ryood/TLF01/TLF01_Antilog/Antilog_NPNO/Analog_Discovery_2/IMG_20201010_154745.jpg

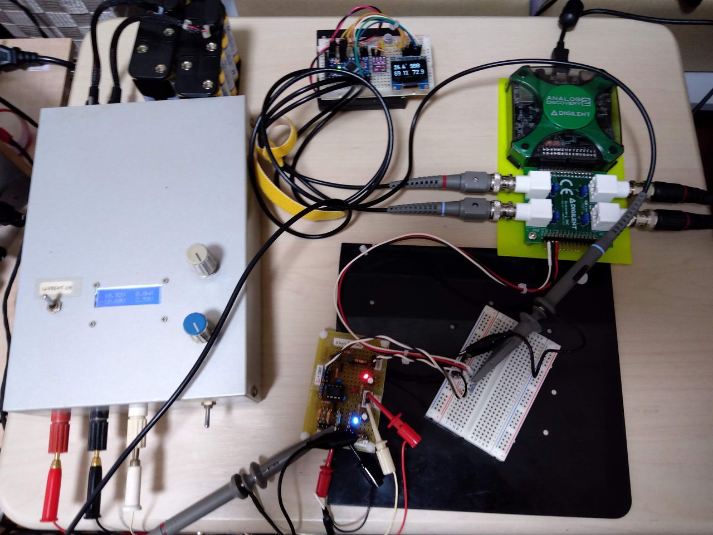
TLF01_Antilog/Antilog_NPNO/Analog_Discovery_2/IMG_20201010_154745.jpg
