ryood/TLF01/eagle/TLF01_brd.png

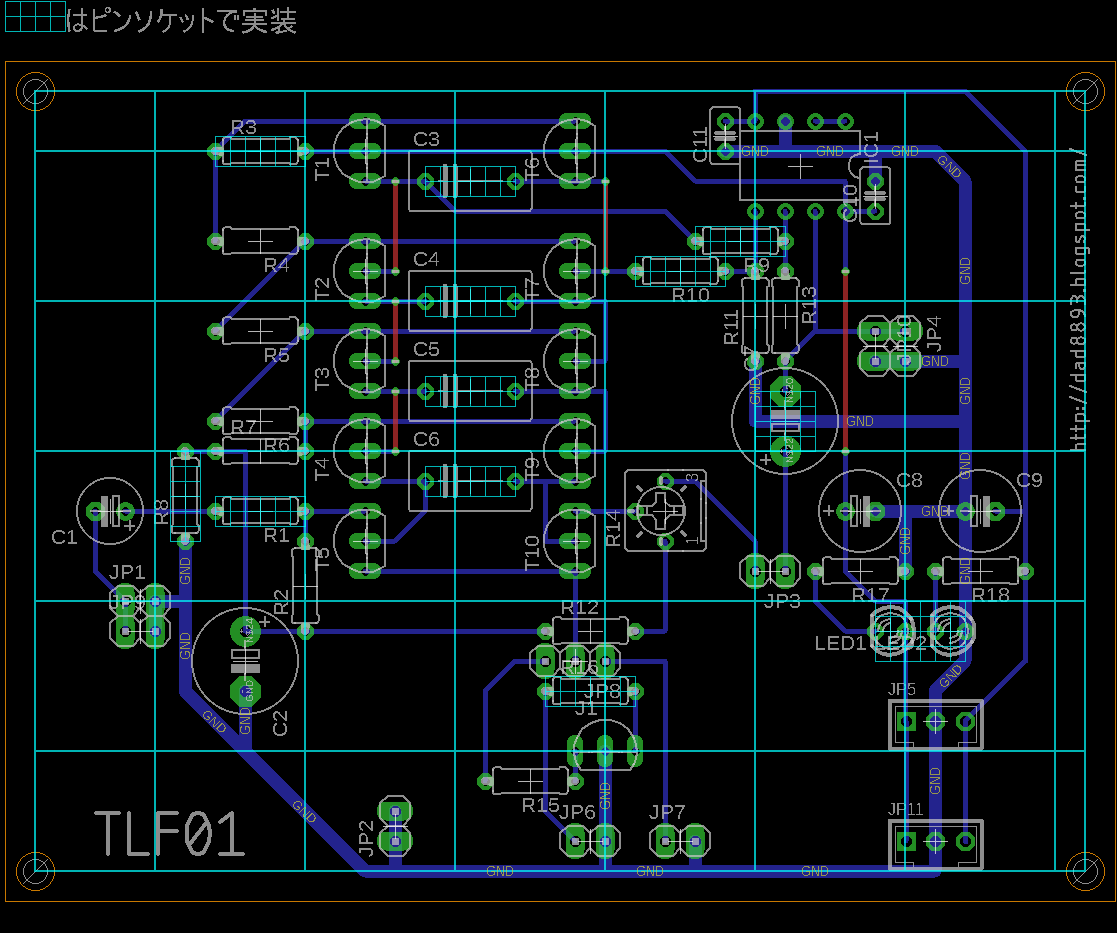
eagle/TLF01_brd.png
