ryood/TLF01/eagle/TLF01_sch.png

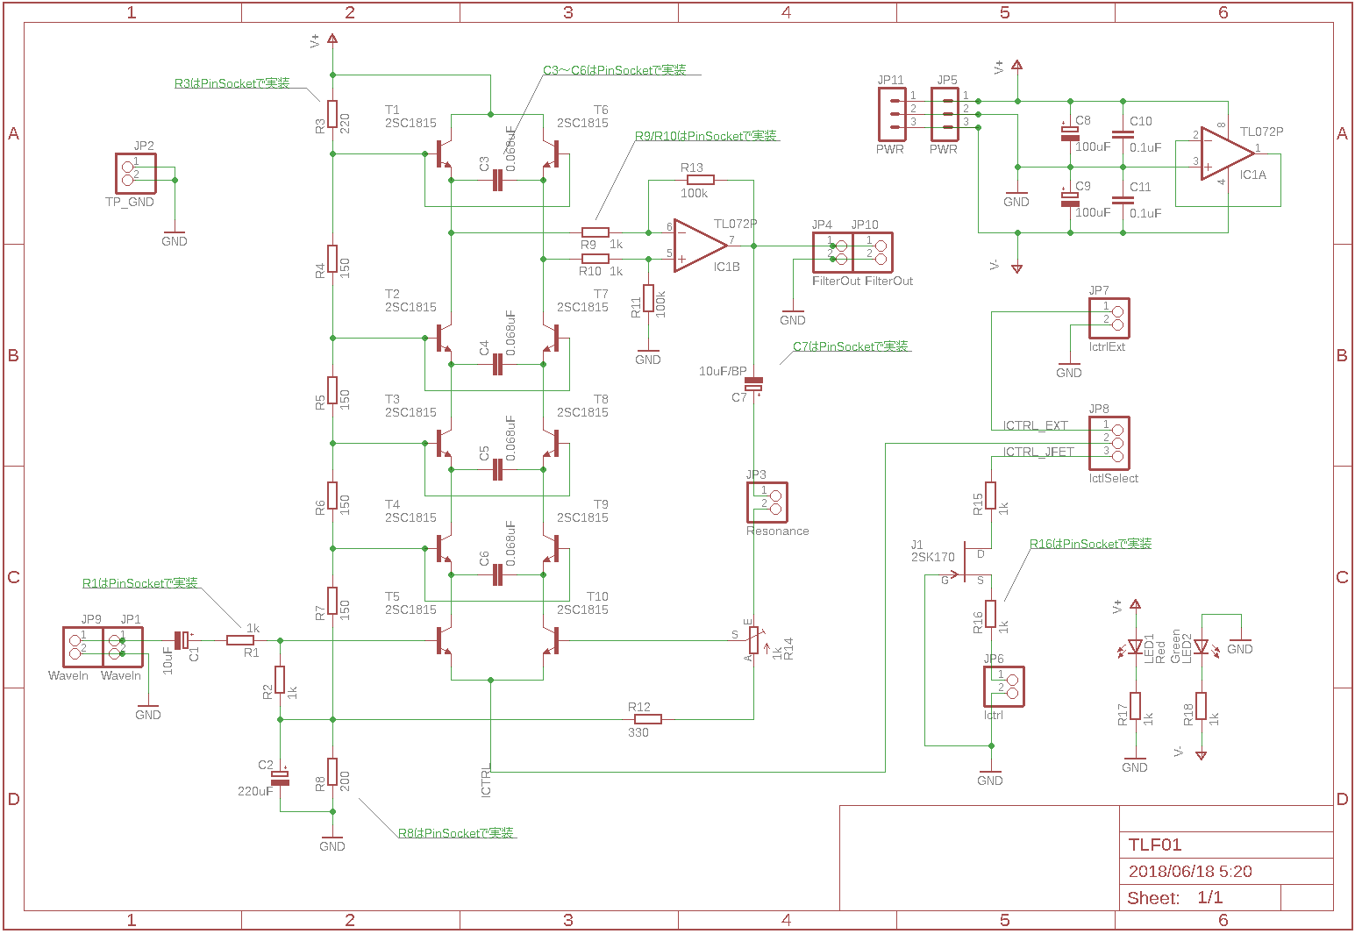
eagle/TLF01_sch.png
