ryood/TLF01/eagle/TLF01_toz_brd.png

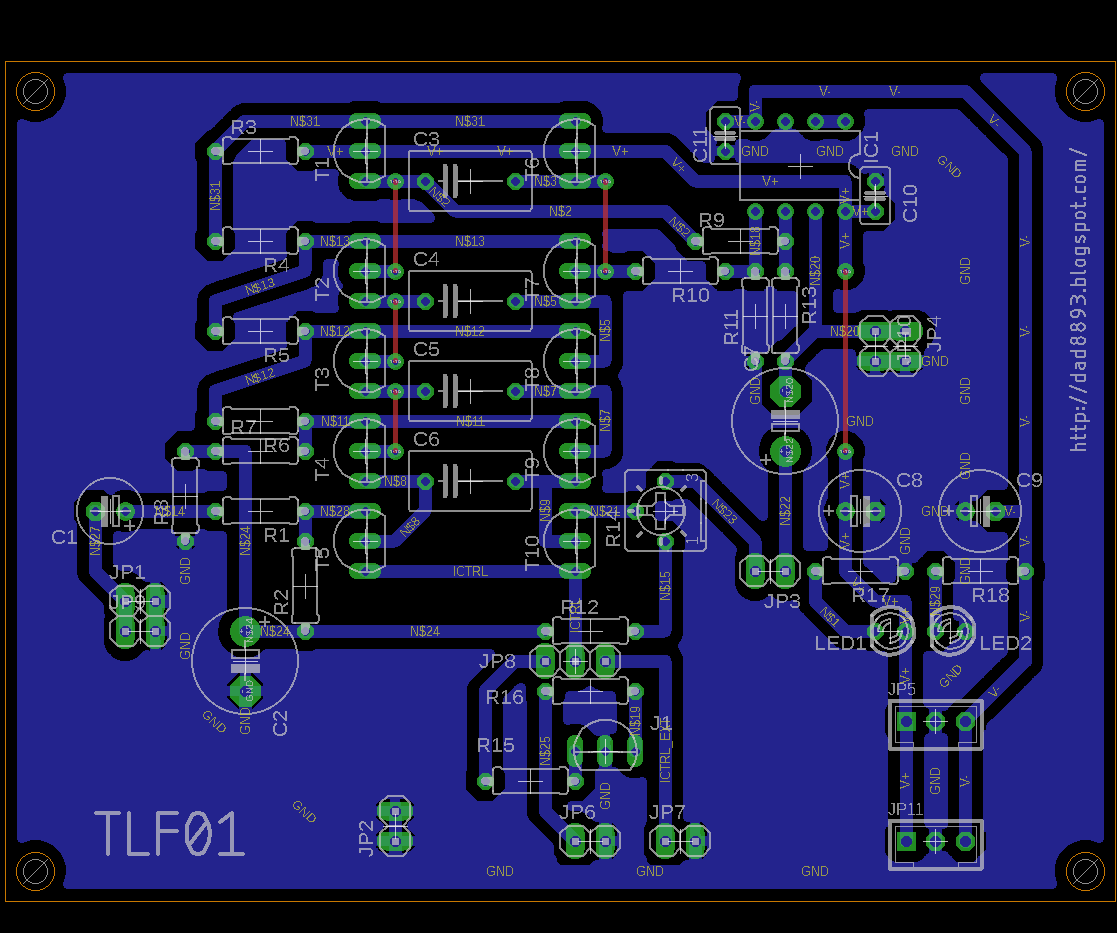
eagle/TLF01_toz_brd.png
