ryood/TLF01/fritzing/MoogLadder_CS_JFET_V2_ブレッドボード.png

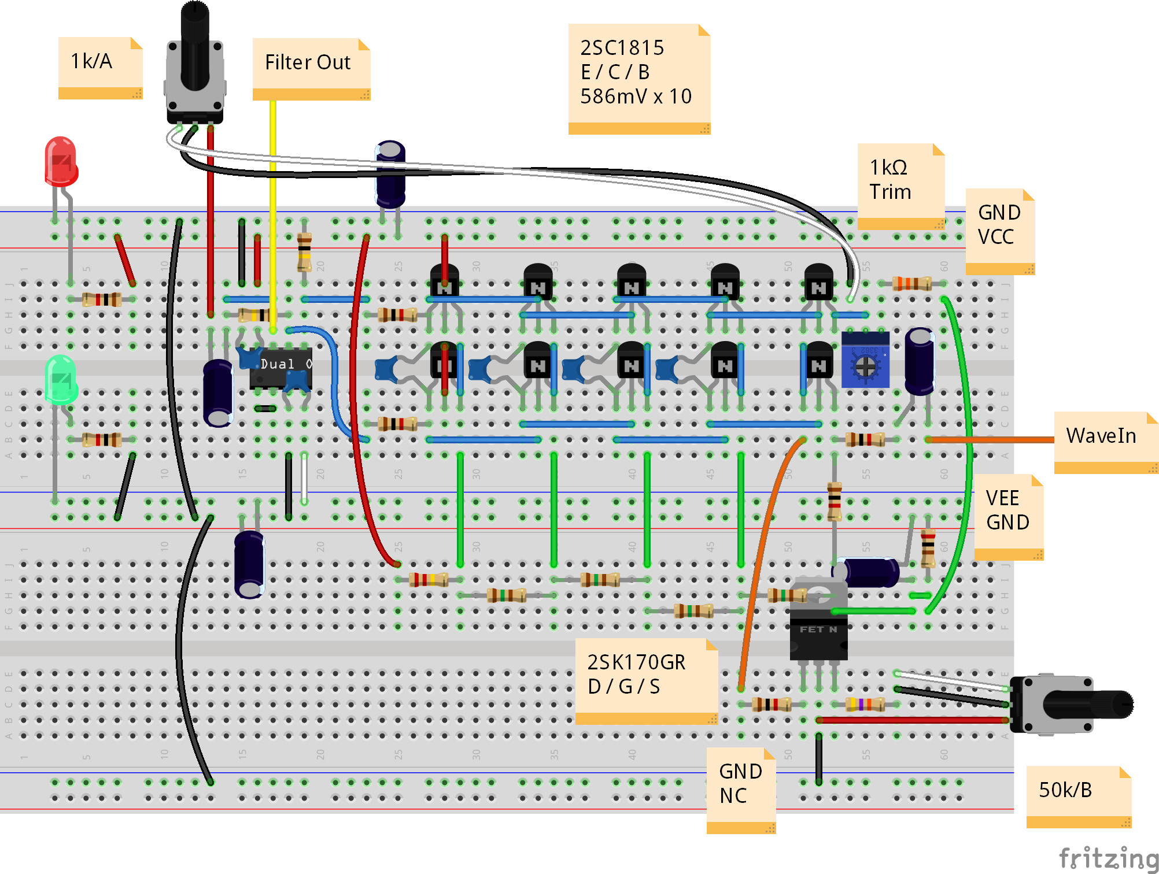
fritzing/MoogLadder_CS_JFET_V2_ブレッドボード.png
