ryood/TLF01/fritzing/TLF01結線図_ブレッドボード.png

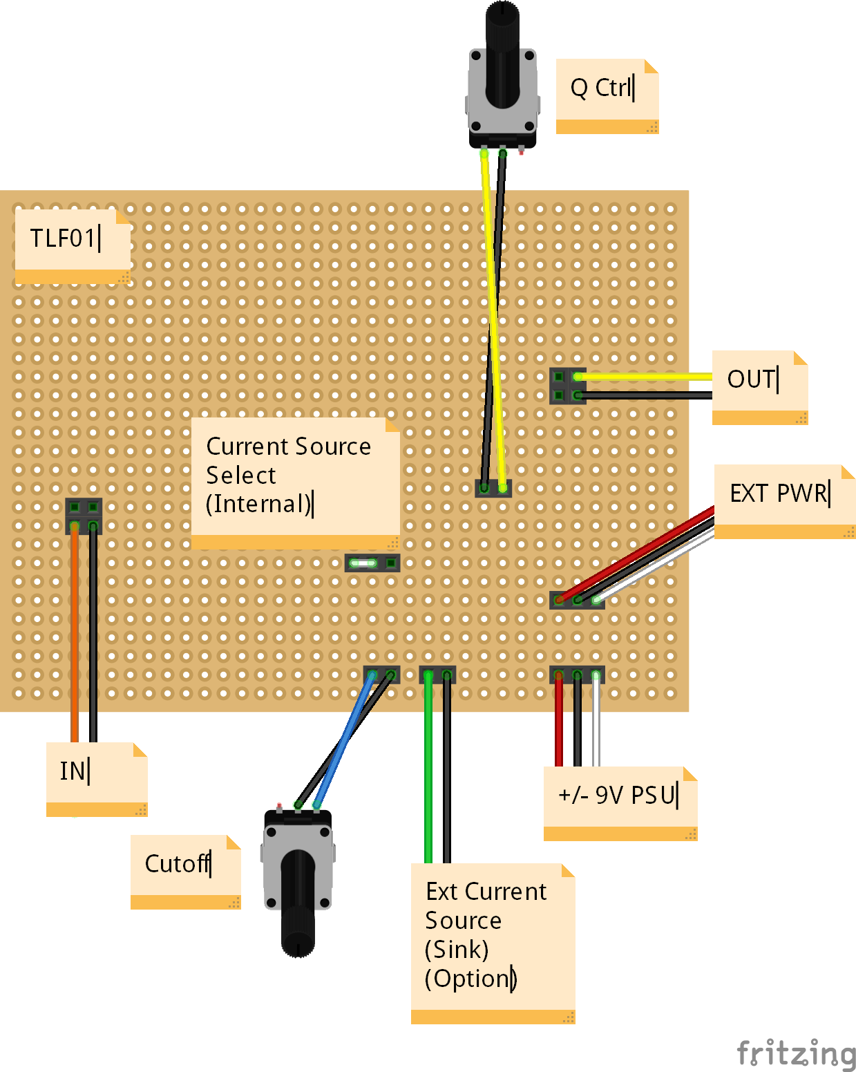
fritzing/TLF01結線図_ブレッドボード.png
