ryood/TLF01/spice/TLF01_sim.png

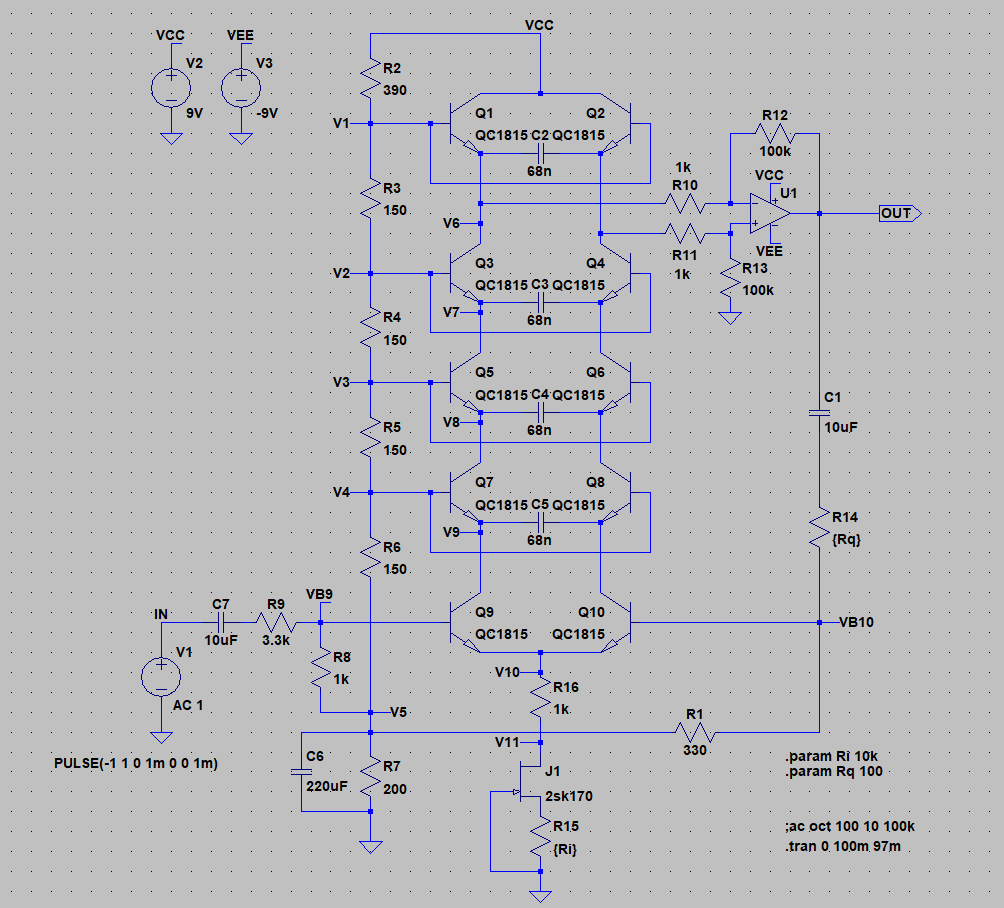
spice/TLF01_sim.png
