ryood/TLF01/spice/TLF01_V1-V5.png

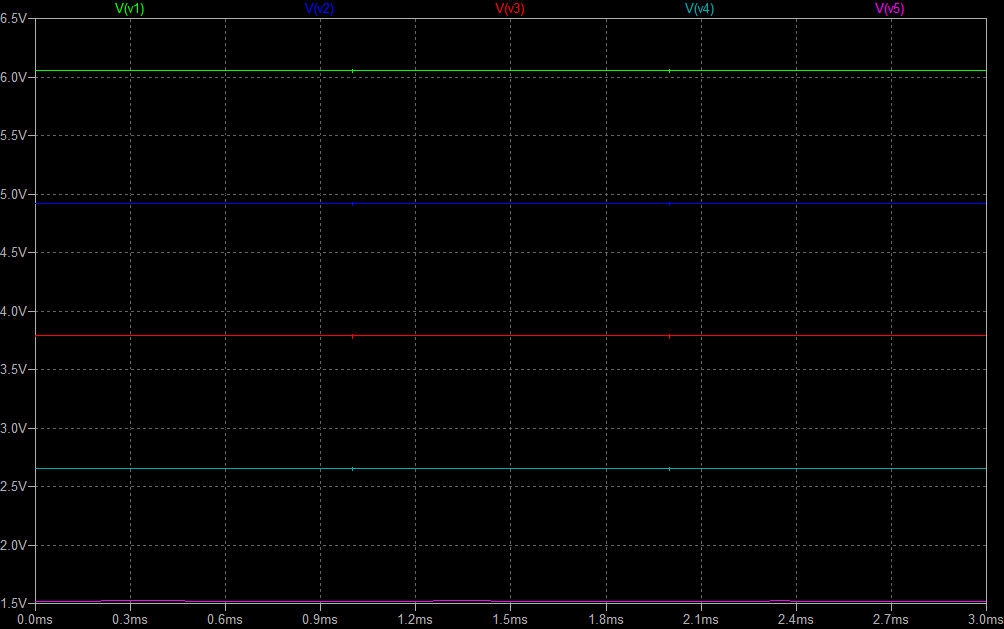
spice/TLF01_V1-V5.png
