ryood/TLF01/spice/TLF01_Vb9_Vb10.png

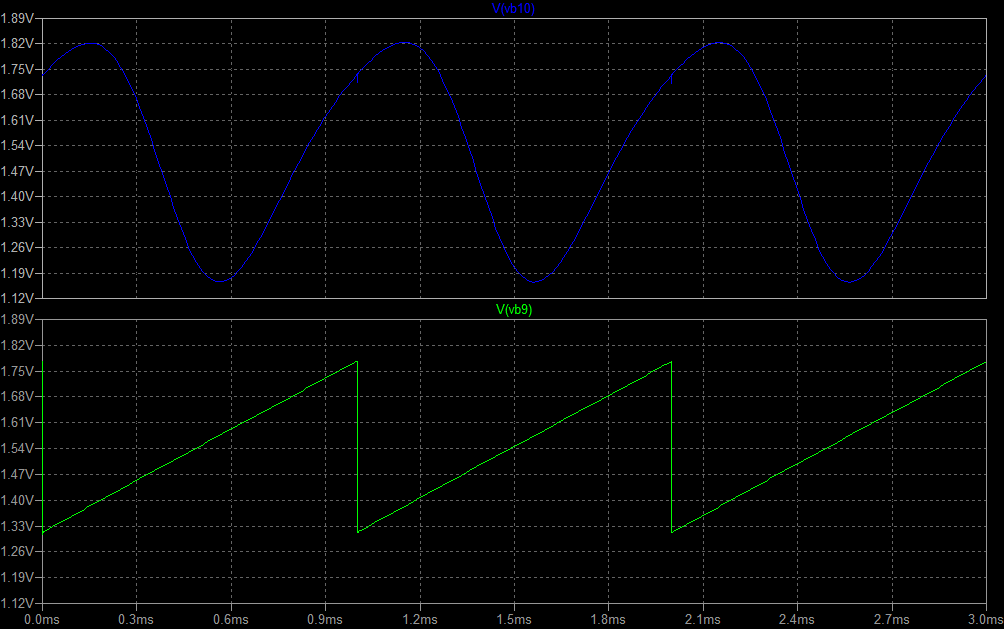
spice/TLF01_Vb9_Vb10.png
