ryood/TLF01/spice/TLF_Cfc_1u.png

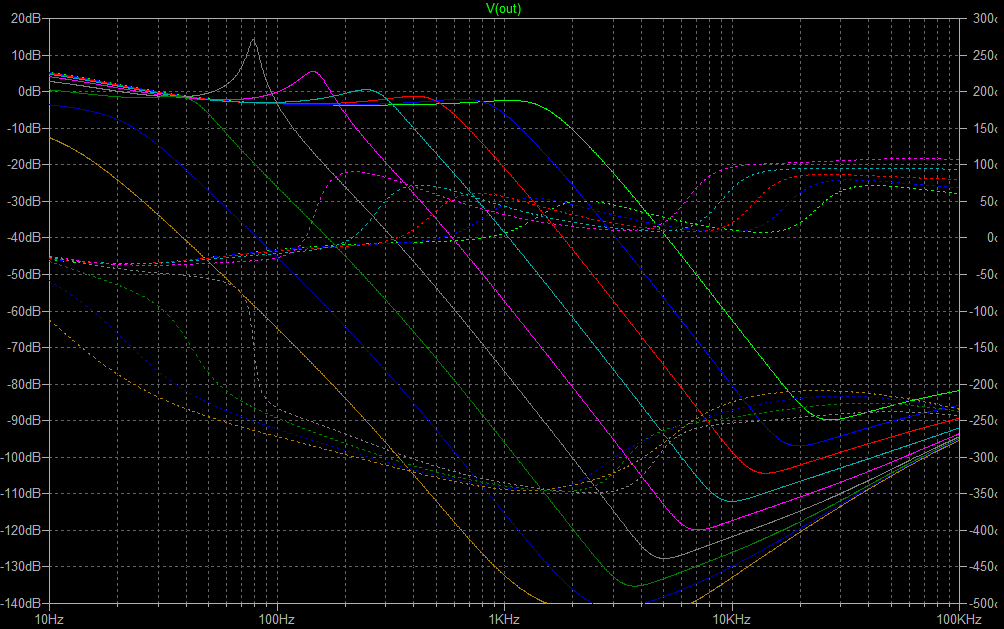
spice/TLF_Cfc_1u.png
