ryood/TLF01/spice/TLF_Cfc_68n.png

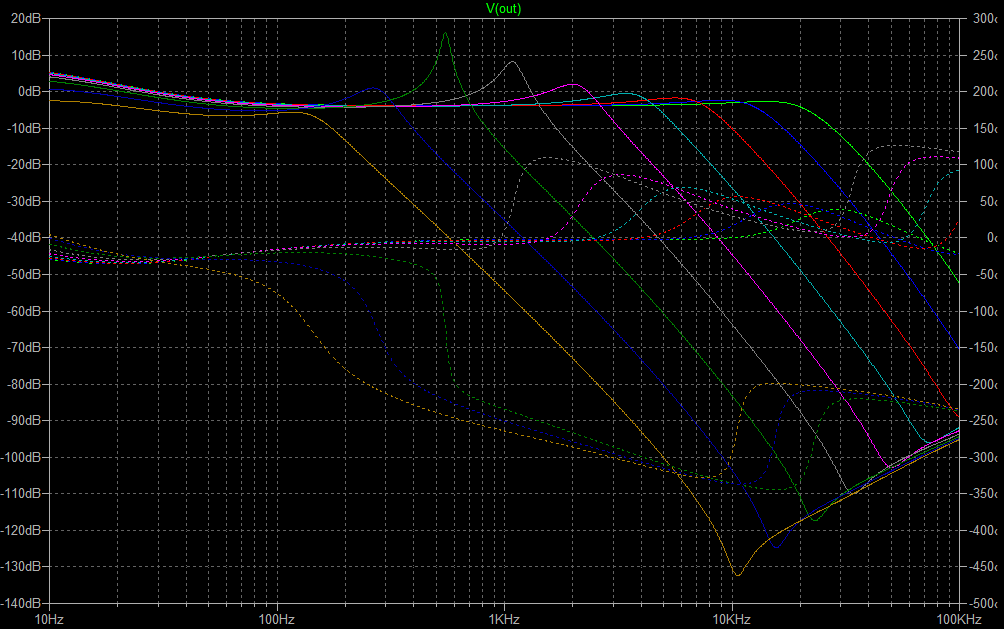
spice/TLF_Cfc_68n.png
