ryood/TLF01/spice/TLF_Cfc_100n.png

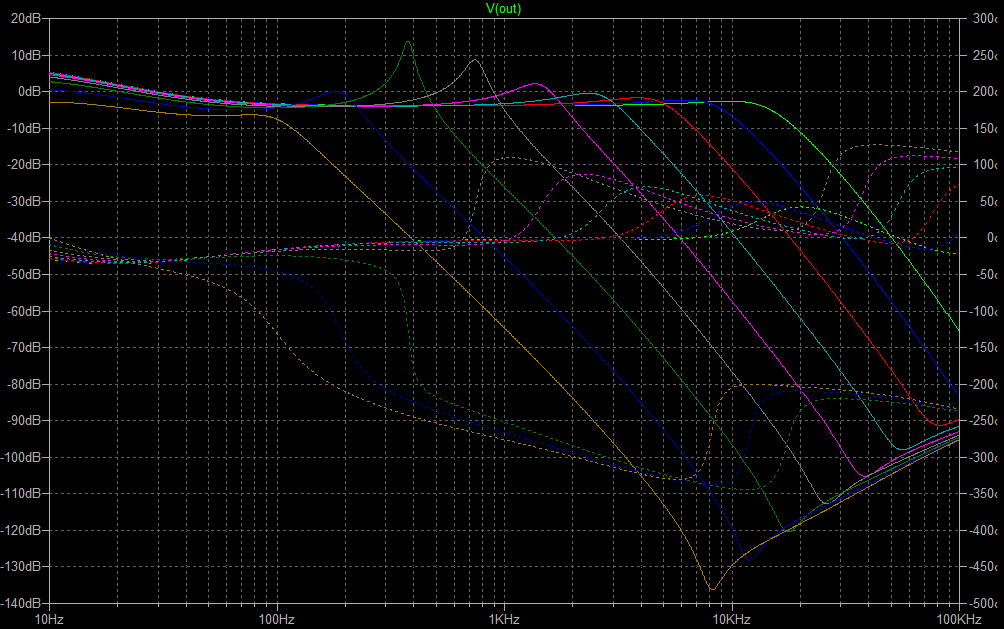
spice/TLF_Cfc_100n.png
