ryood/TLF01/spice/TLF_Cq_1uF.png

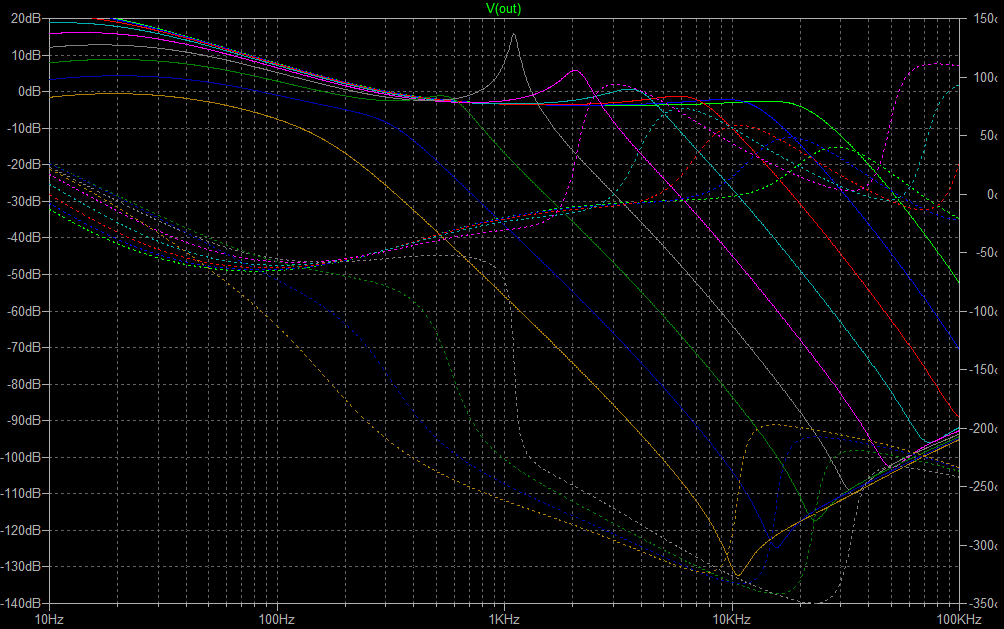
spice/TLF_Cq_1uF.png
