ryood/TLF01/spice/TLF_Ramp_1k.png

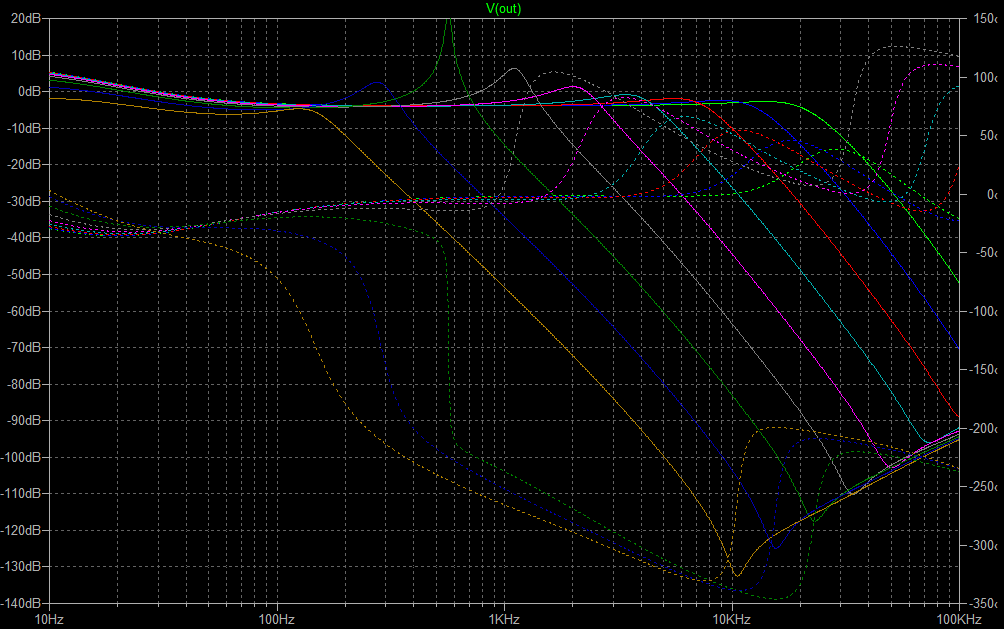
spice/TLF_Ramp_1k.png
