ryood/TLF01/spice/TLF_Ramp_4.7k.png

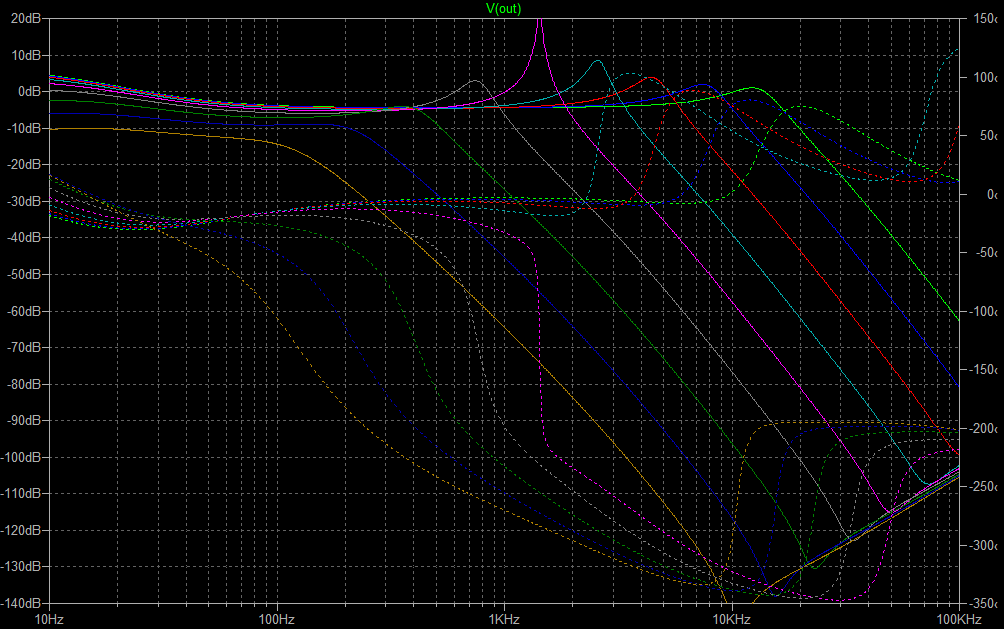
spice/TLF_Ramp_4.7k.png
