ryood/TLF01/spice/TLF_Ramp_10k.png

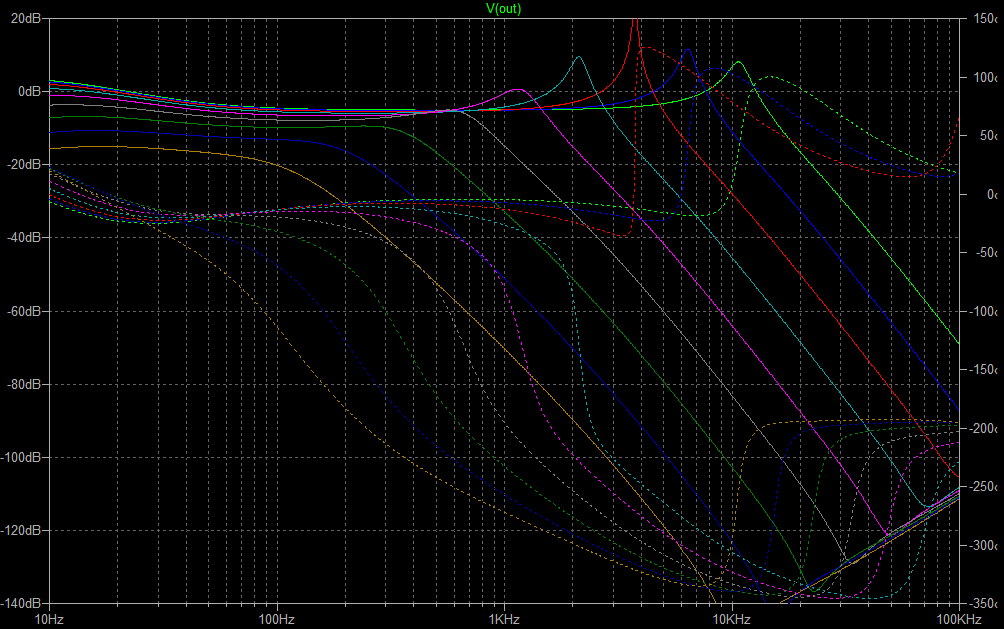
spice/TLF_Ramp_10k.png
