ryood/TLF01/spice/TLF_Ramp_100.png

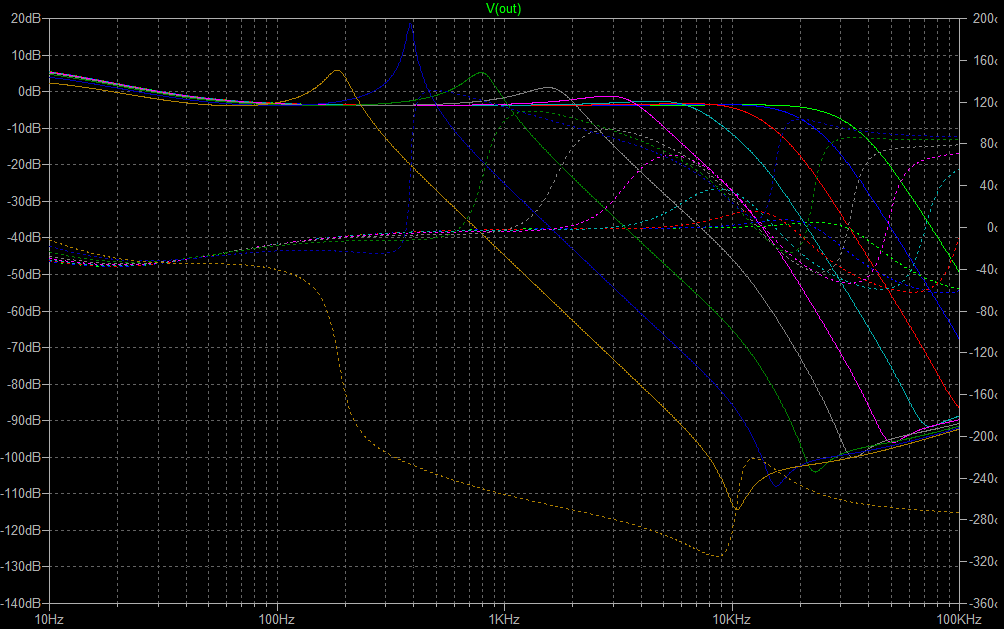
spice/TLF_Ramp_100.png
