ryood/TLF01/spice/TLF_Rin_1k.png

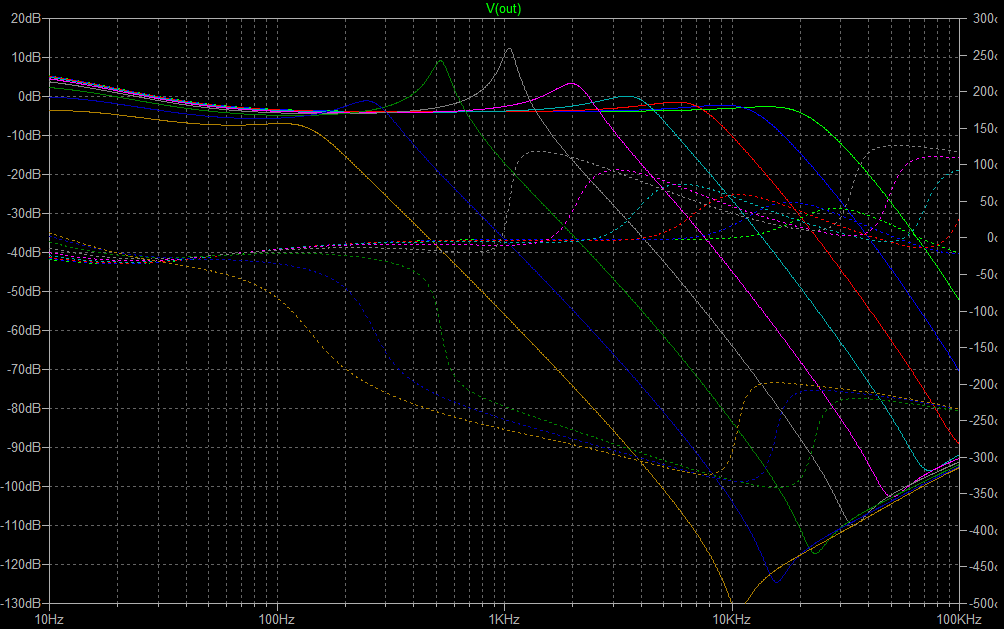
spice/TLF_Rin_1k.png
