ryood/TLF01/spice/TLF_Rin_100.png

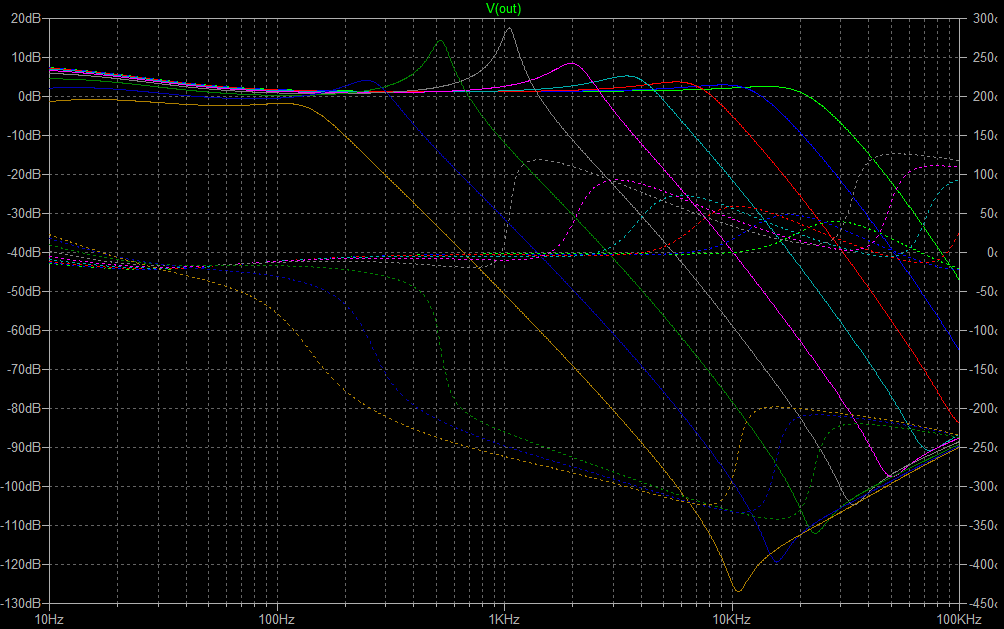
spice/TLF_Rin_100.png
