ryood/TLF01/TLF01_Antilog/Antilog-MM/eagle/AngilogMM_brd.png

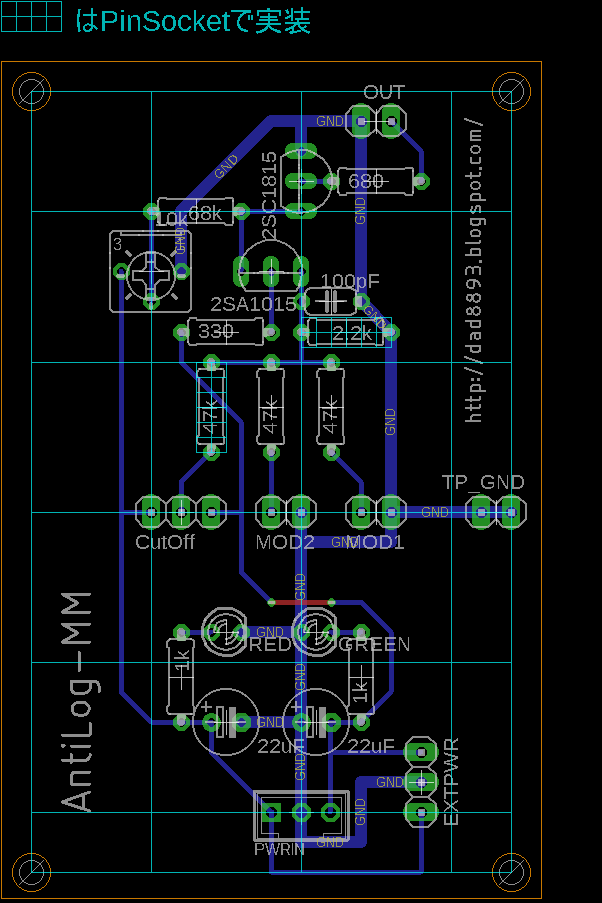
TLF01_Antilog/Antilog-MM/eagle/AngilogMM_brd.png
