ryood/TLF01/TLF01_Antilog/Antilog-MM/eagle/AngilogMM_brd_rev.png

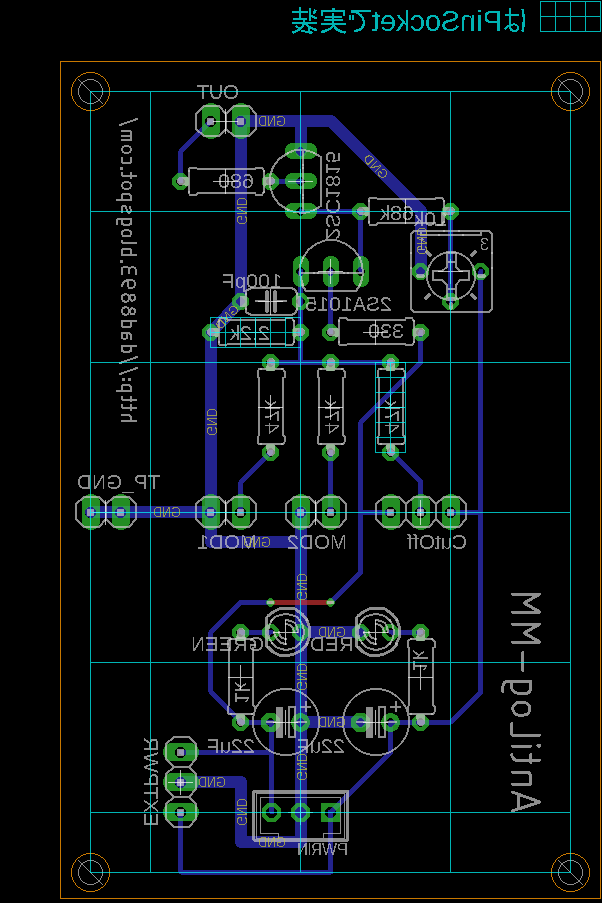
TLF01_Antilog/Antilog-MM/eagle/AngilogMM_brd_rev.png
