ryood/TLF01/TLF01_Antilog/Antilog-MM/eagle/AngilogMM_sch.png

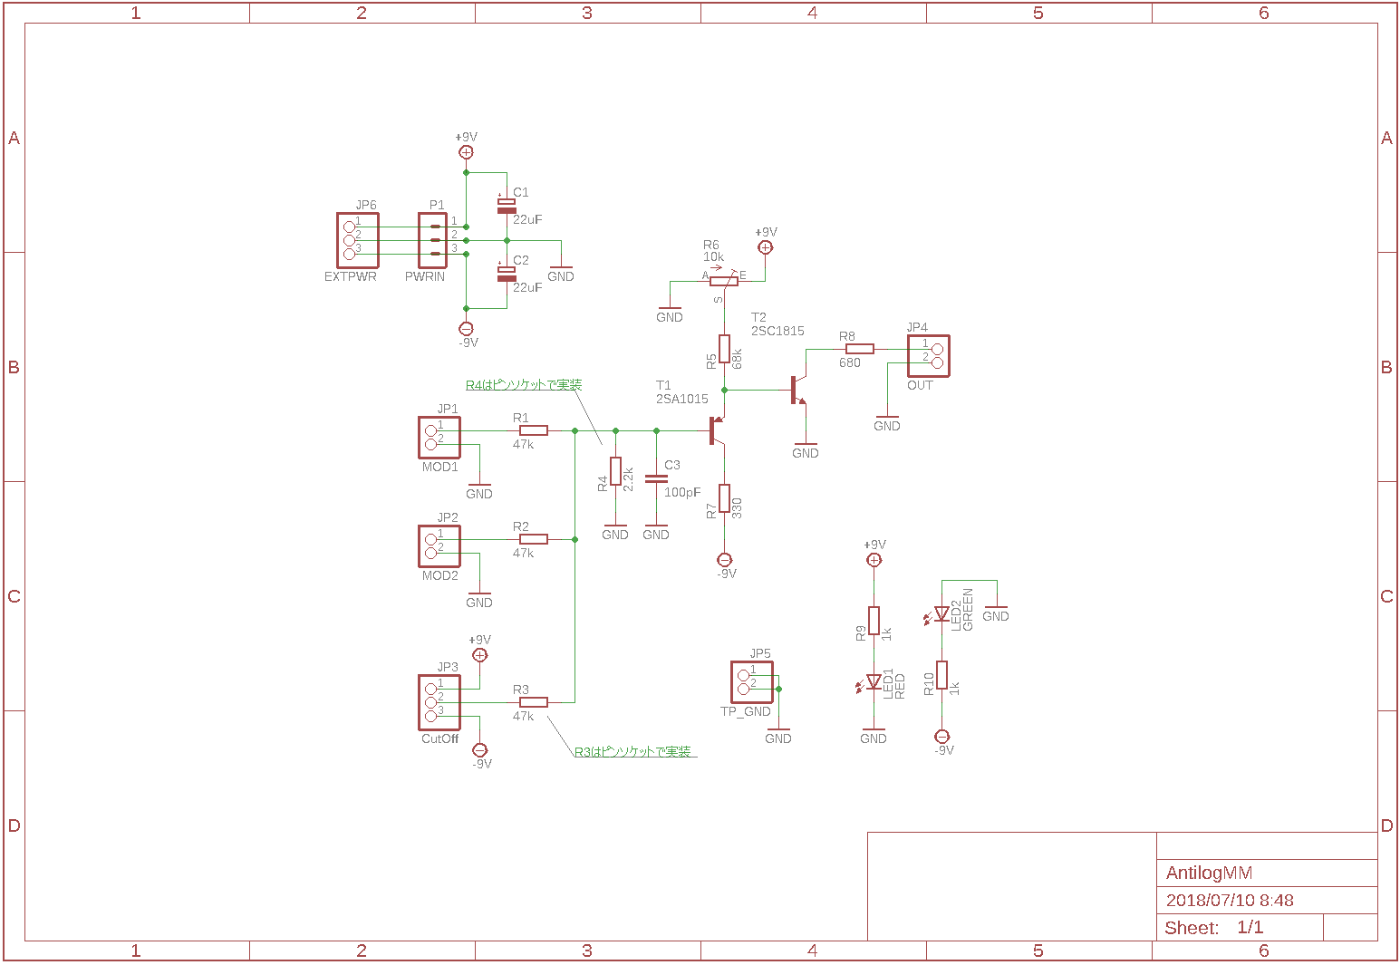
TLF01_Antilog/Antilog-MM/eagle/AngilogMM_sch.png
