ryood/TLF01/TLF01_Antilog/Antilog-MM/fritzing/TLF01+Antilog_ Analog2.0_ブレッドボード.png

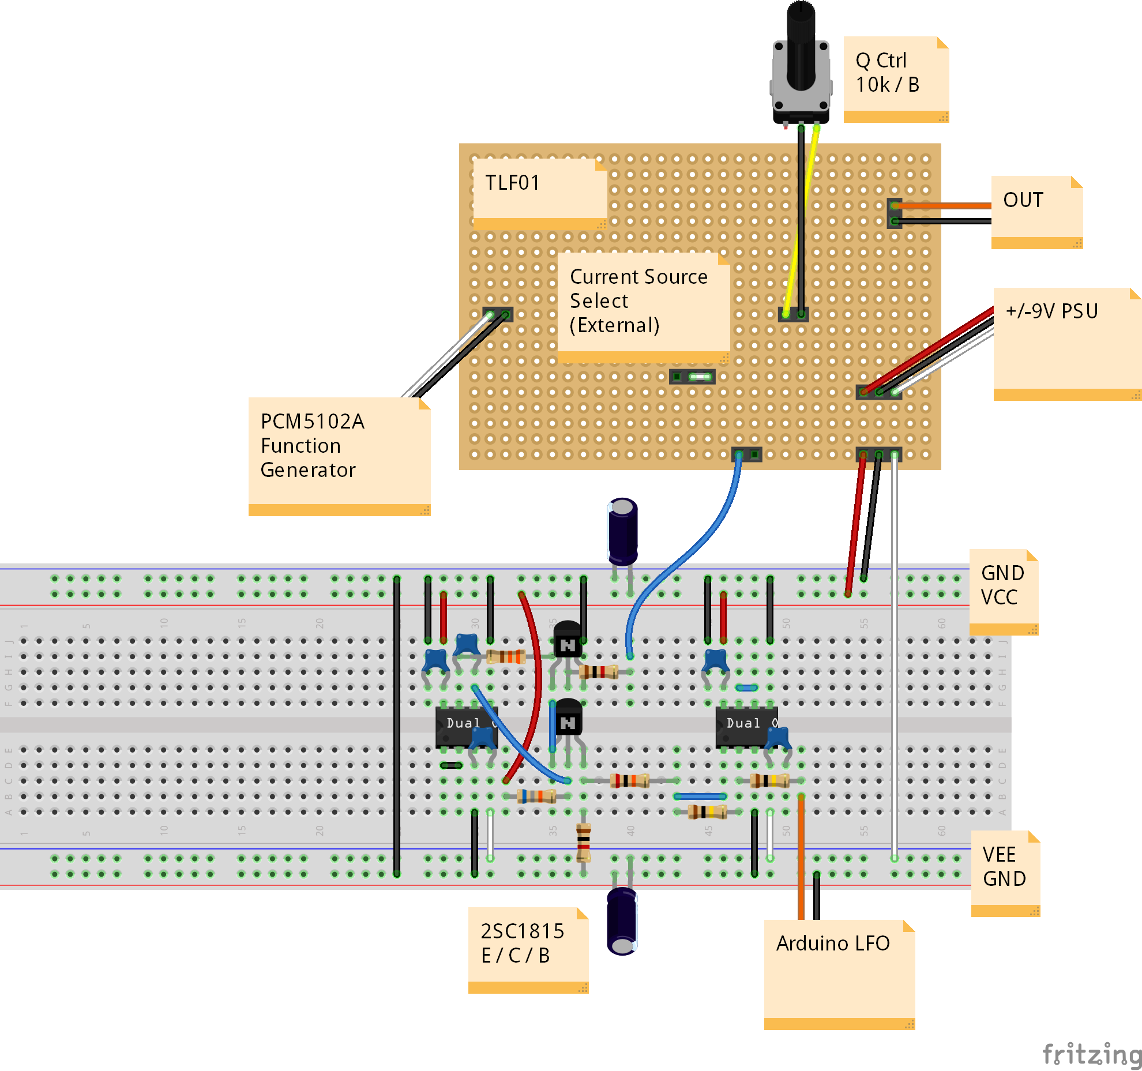
TLF01_Antilog/Antilog-MM/fritzing/TLF01+Antilog_ Analog2.0_ブレッドボード.png
