ryood/TLF01/TLF01_Antilog/Antilog-MM/spice/TLF01+AntiLogMM_GND.png

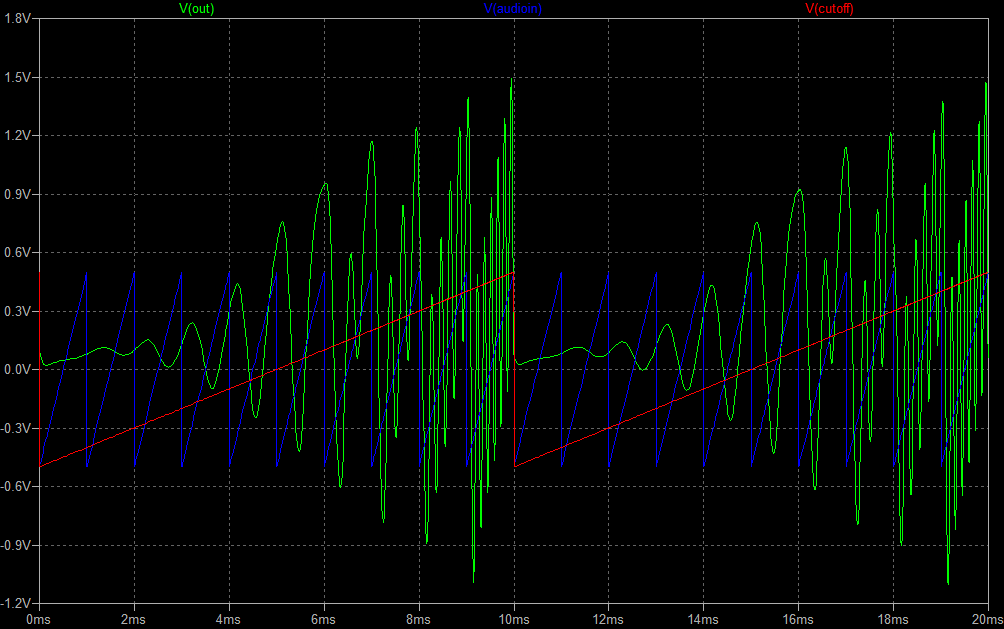
TLF01_Antilog/Antilog-MM/spice/TLF01+AntiLogMM_GND.png
