ryood/TLF01/TLF01_Antilog/Antilog-MM/spice/TLF01+AntiLogMM_VEE.png

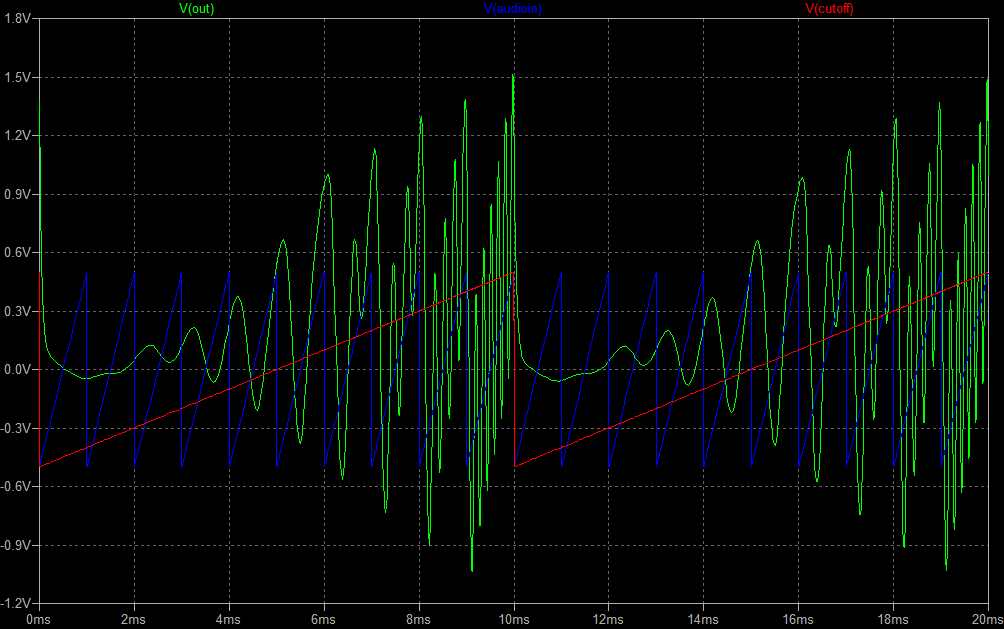
TLF01_Antilog/Antilog-MM/spice/TLF01+AntiLogMM_VEE.png
