ryood/TLF01/TLF01_Antilog/Antilog_NPNO/Analog_Discovery_2/Antilog_NPNO_InOut.png

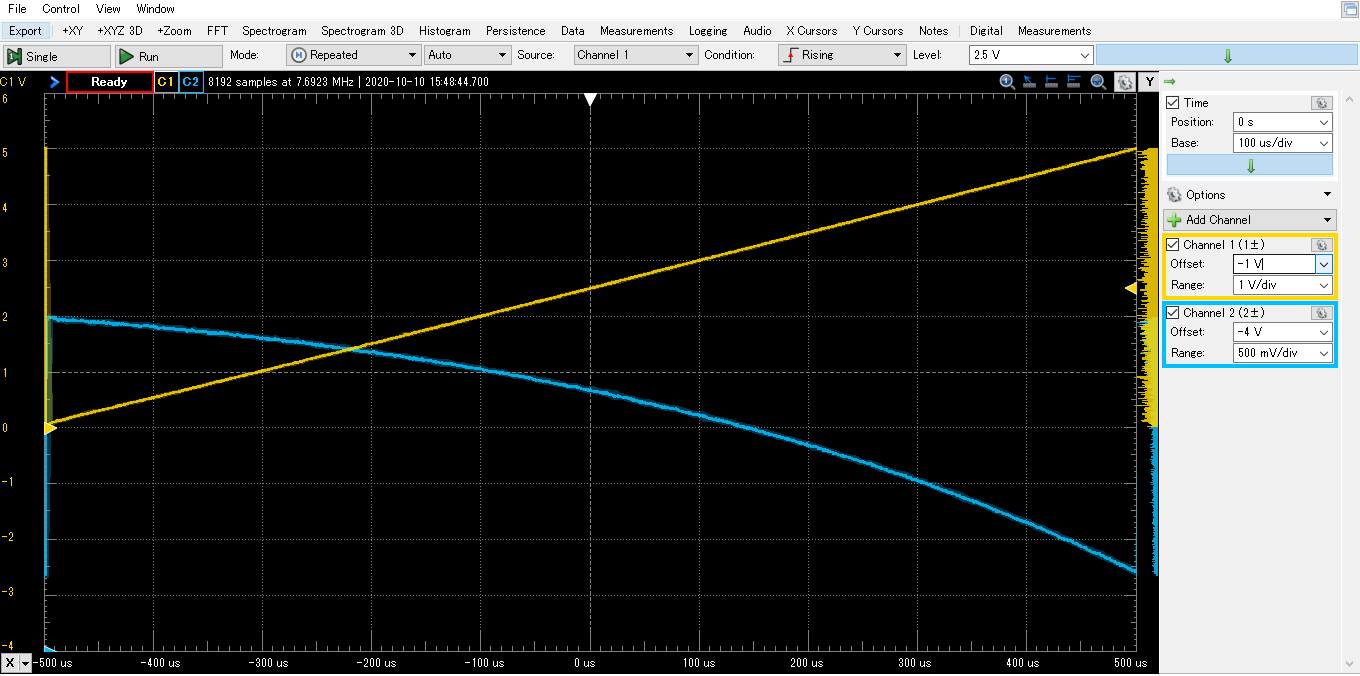
TLF01_Antilog/Antilog_NPNO/Analog_Discovery_2/Antilog_NPNO_InOut.png
