ryood/TLF01/TLF01_Antilog/Antilog_NPNO/Analog_Discovery_2/Antilog_NPNO_Vin_Vs_Iout.png

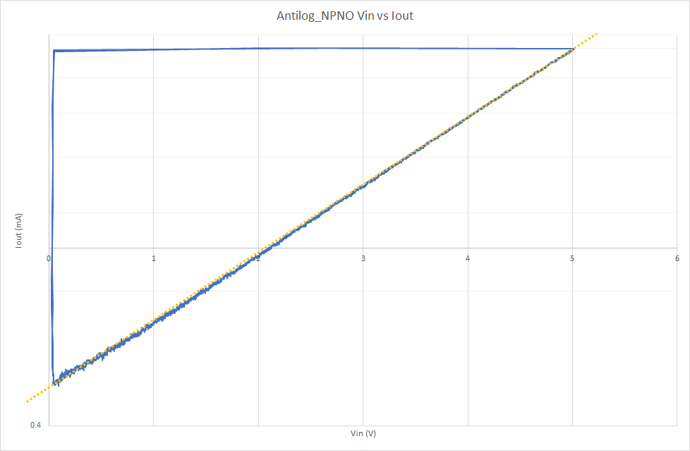
TLF01_Antilog/Antilog_NPNO/Analog_Discovery_2/Antilog_NPNO_Vin_Vs_Iout.png
