ryood/TLF01/TLF01_Antilog/Antilog_NPNO/eagle/Antilog-NPNO_brd.png

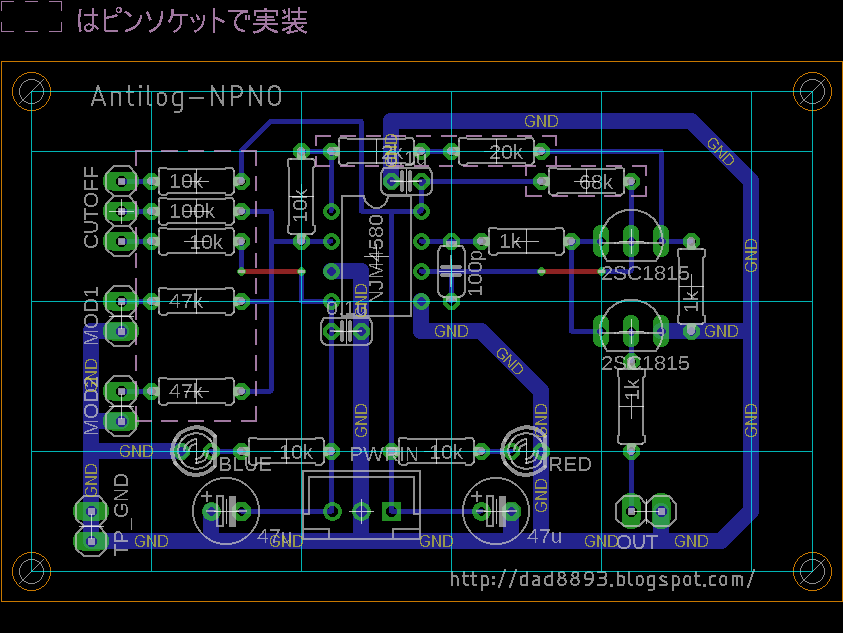
TLF01_Antilog/Antilog_NPNO/eagle/Antilog-NPNO_brd.png
