ryood/TLF01/TLF01_Antilog/Antilog_NPNO/fritzing/Antilog_NPNO_ブレッドボード.png

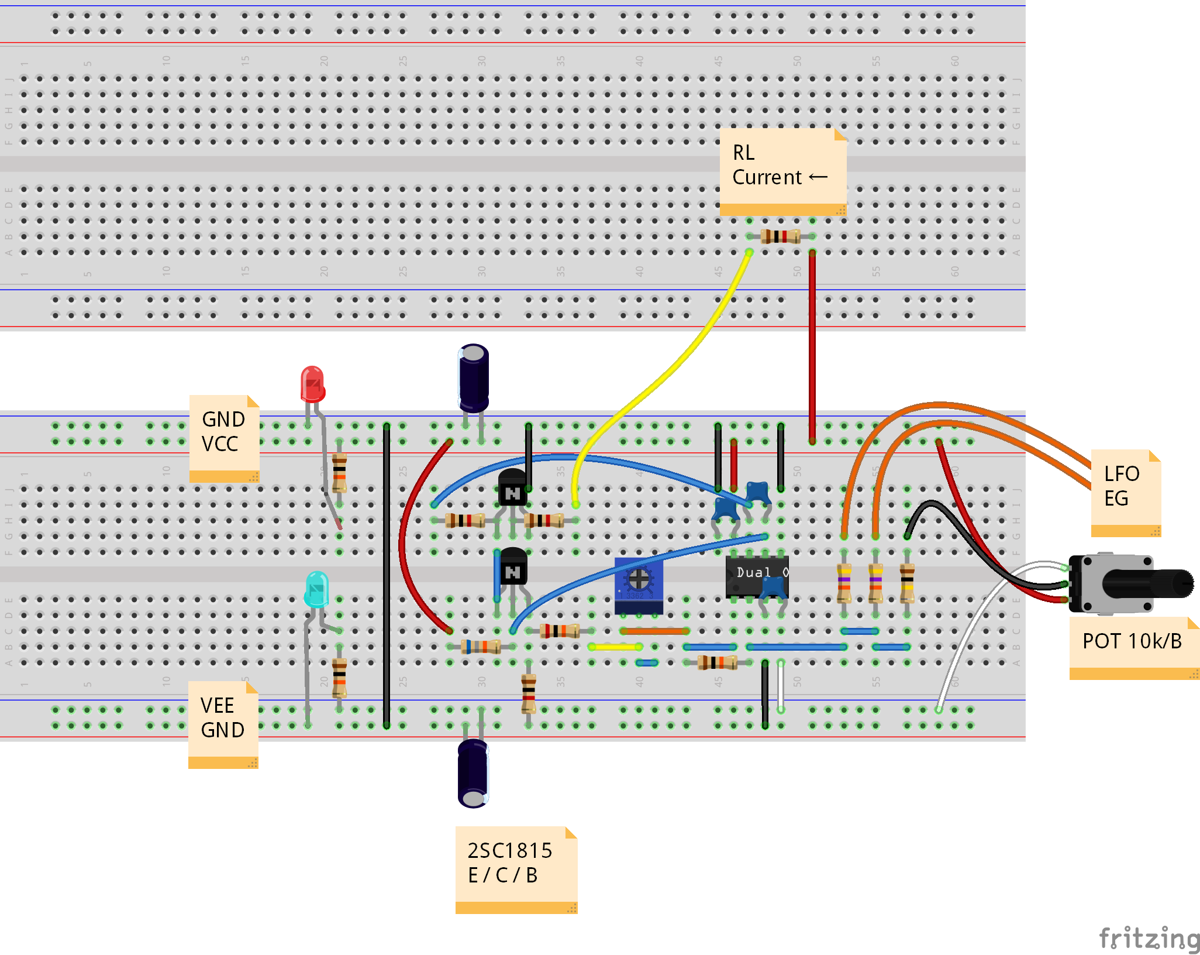
TLF01_Antilog/Antilog_NPNO/fritzing/Antilog_NPNO_ブレッドボード.png
