ryood/TLF01/TLF01_Antilog/Antilog_NPNO/spice/Antilog-NPNO_sim.png

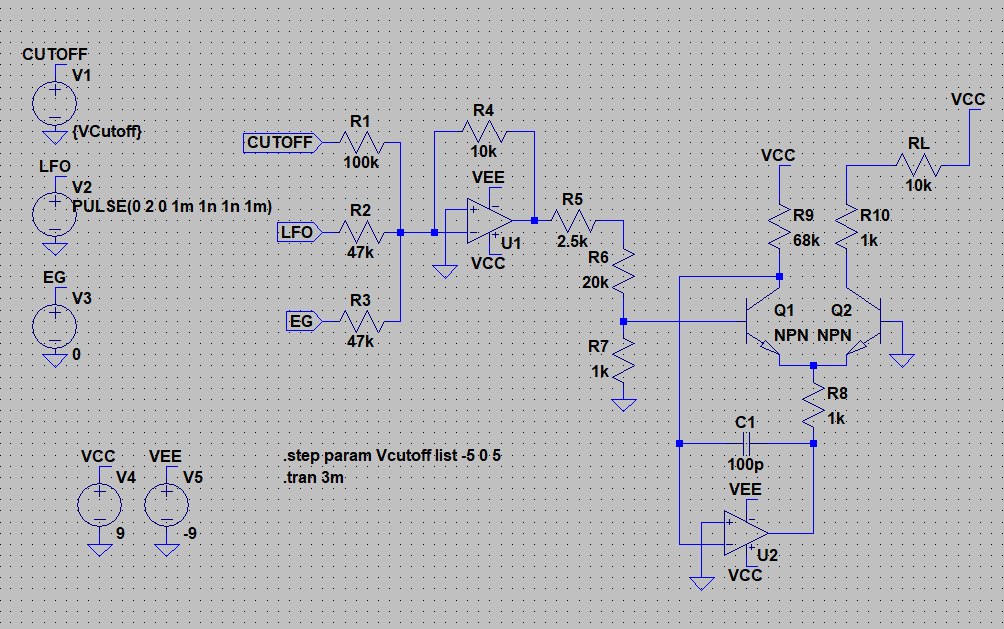
TLF01_Antilog/Antilog_NPNO/spice/Antilog-NPNO_sim.png
