ryood/TLF01/TLF01_Antilog/TLF01 + AntiLog ブロック図.png

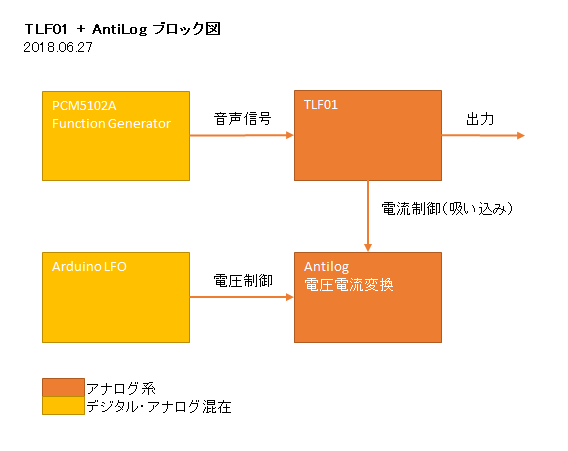
TLF01_Antilog/TLF01 + AntiLog ブロック図.png
