ryood/TLF01/TLF01_Antilog/Antilog_NPNO/Analog_Discovery_2/Antilog-NPNO_Test_Diagram.xlsx

Antilog-NPNO Test Diagram
2020.10.12
 | アナログ系
 | D/A混在
 | 電源系
 | 測定系
