ryood/TLF01/TLF01_Antilog/Antilog-MM/fritzing/AntiLog-MM_Unit_Test_ブレッドボード.png

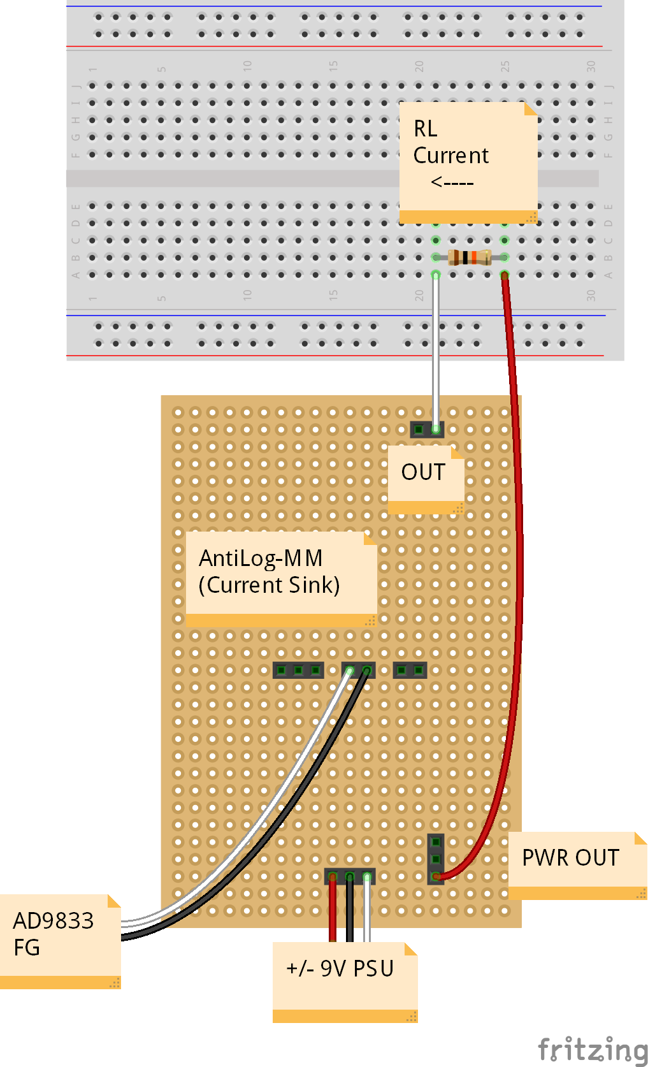
TLF01_Antilog/Antilog-MM/fritzing/AntiLog-MM_Unit_Test_ブレッドボード.png
