ryood/TLF01/TLF01_Antilog/Antilog-MM/fritzing/TLF01+Antilog-MM_Test_ブレッドボード.png

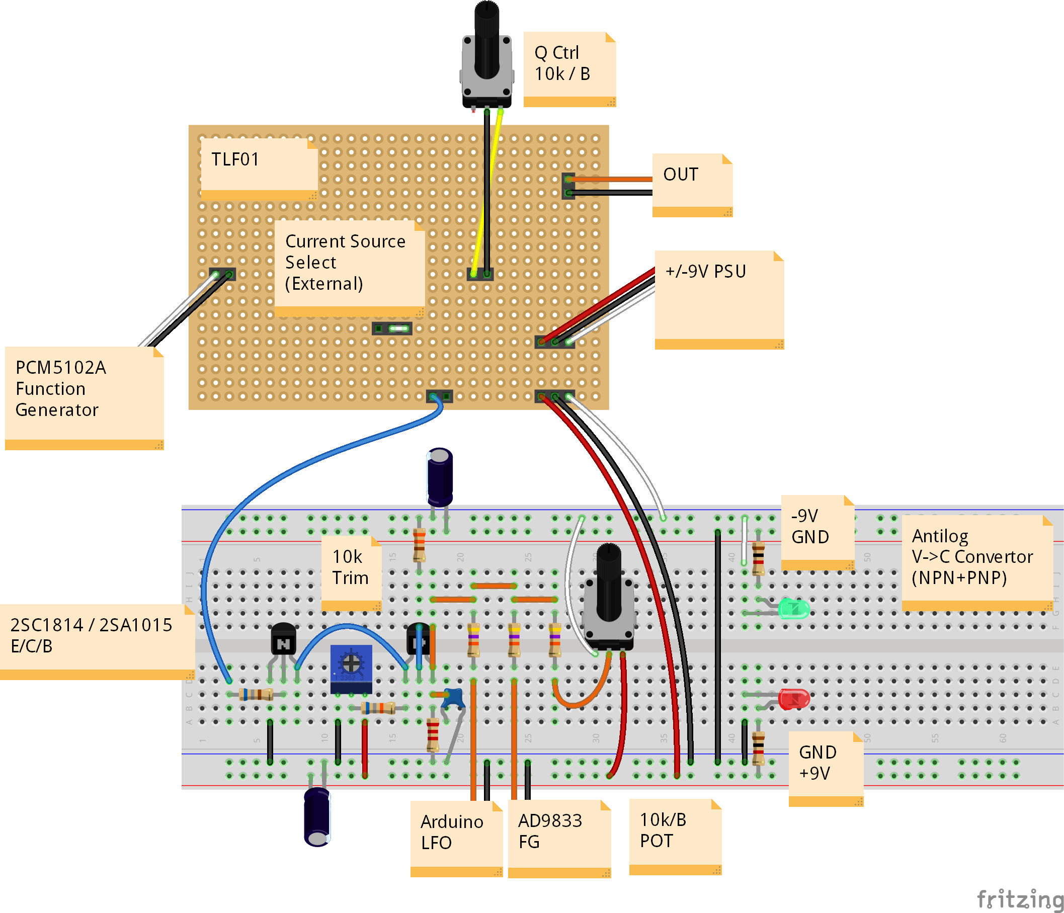
TLF01_Antilog/Antilog-MM/fritzing/TLF01+Antilog-MM_Test_ブレッドボード.png
