ryood/TLF01/TLF01_Antilog/Antilog_NPNO/Analog_Discovery_2/Antilog-NPNO_Test_Diagram.png

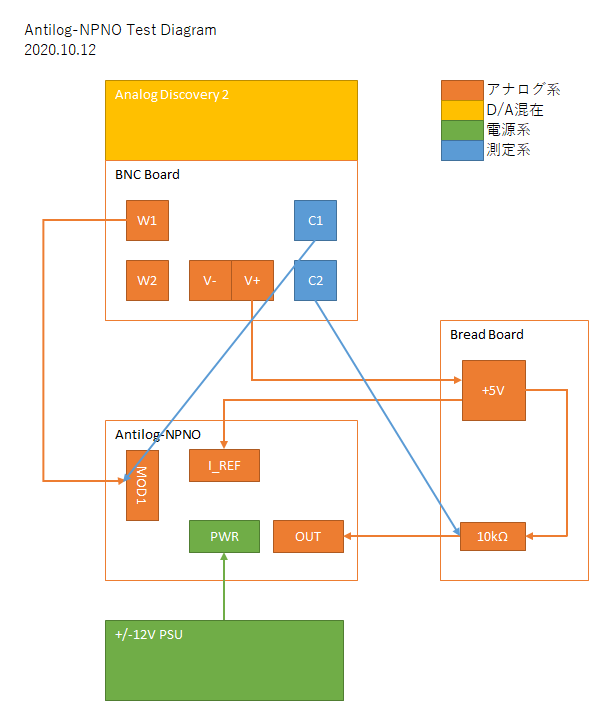
TLF01_Antilog/Antilog_NPNO/Analog_Discovery_2/Antilog-NPNO_Test_Diagram.png
