ryood/TLF01/TLF01_Antilog/Antilog_NPNO/fritzing/Antilog_Diff_Unit_Test_ブレッドボード.png

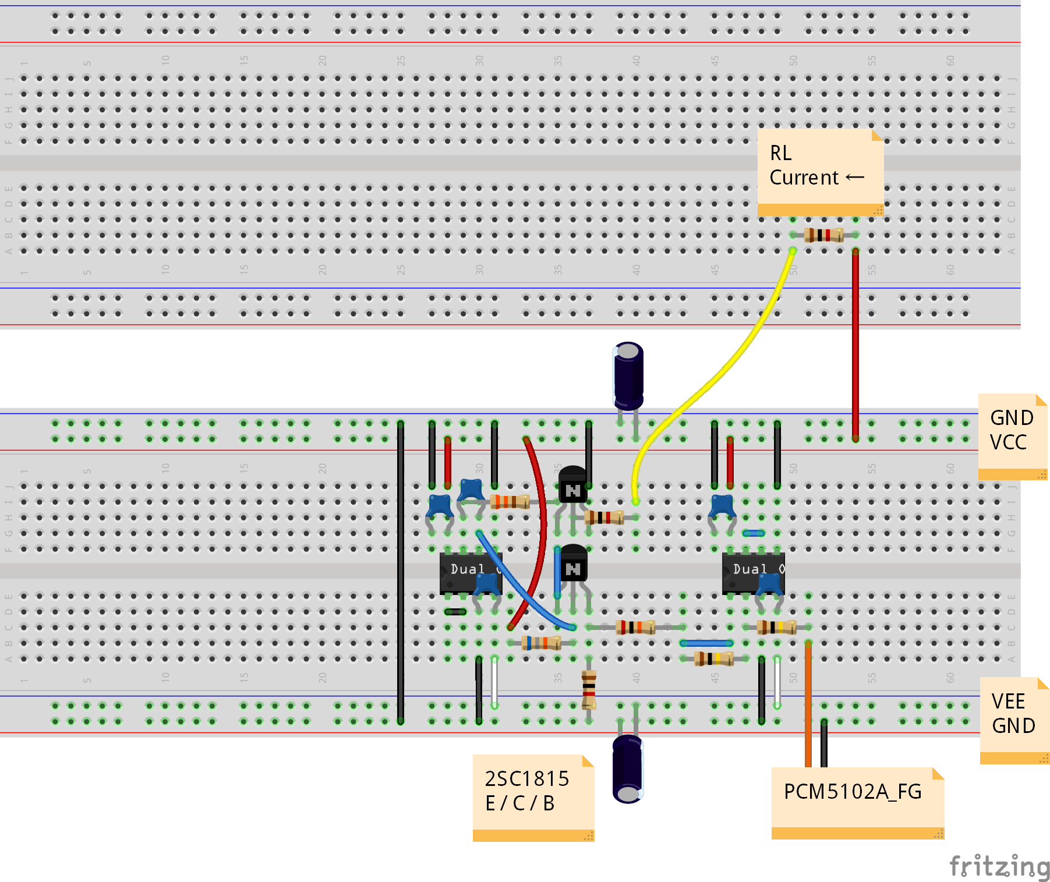
TLF01_Antilog/Antilog_NPNO/fritzing/Antilog_Diff_Unit_Test_ブレッドボード.png
