ryood/TLF01/spice/Analog2_0_Ladder_DiffAmp_CS_AntiLog_R9V_qctrl.asc

C1: cap; 10uF
C2: cap; 68n
C3: cap; 68n
C4: cap; 68n
C5: cap; 68n
C6: cap; 220uF
C7: cap; 10uF
Q1: npn; QC1815
Q2: npn; QC1815
Q3: npn; QC1815
Q4: npn; QC1815
Q5: npn; QC1815
Q6: npn; QC1815
Q7: npn; QC1815
Q8: npn; QC1815
Q9: npn; QC1815
Q10: npn; QC1815
Q11: pnp; QA1015
Q12: npn; QC1815
R1: res; 330
R2: res; 220
R3: res; 120
R4: res; 120
R5: res; 120
R6: res; 120
R7: res; 200
R8: res; 1k
R9: res; 4.7k
R10: res; 1k
R11: res; 1k
R12: res; 100k
R13: res; 100k
R14: res; {Rq}
R16: res; 4.7k
R17: res; 68k
R18: res; 1k
R19: res; 330
R20: res; 47k
U1: UniversalOpamp2
V1: voltage; PULSE(-0.5 0.5 0 1m 1n 1n 1m); AC 1
V2: voltage; 9V
V3: voltage; -9V
V4: voltage; {Vfc}
V5: voltage; {Vref}
Named nets: 0, VCC, OUT, WaveIn, V1, V2, V3, V4, V5, VB11, VB12, VEE, VREF, FcCtrl
.ac oct 100 10 100k
;tran 0 100m 97m
;.step param Vfc list 10m 50m 100m 500m 1 2 5
;.param Rq 100
.param Vfc 300m
;.step param Vref 1 9 1
.param Vref 1
.step param Rq 1k 5k 1k
