ryood/TLF01/spice/TLF01_Inspection_20190501.asc

C1: cap; 10uF
C2: cap; 68n
C3: cap; 68n
C4: cap; 68n
C5: cap; 68n
C6: cap; 220uF
C7: cap; 10uF
J1: njf; 2sk170
Q1: npn; QC1815
Q2: npn; QC1815
Q3: npn; QC1815
Q4: npn; QC1815
Q5: npn; QC1815
Q6: npn; QC1815
Q7: npn; QC1815
Q8: npn; QC1815
Q9: npn; QC1815
Q10: npn; QC1815
R1: res; 330
R2: res; 390
R3: res; 150
R4: res; 150
R5: res; 150
R6: res; 150
R7: res; 200
R8: res; 1k
R9: res; 3.3k
R10: res; 1k
R11: res; 1k
R12: res; 100k
R13: res; 100k
R14: res; {Rq}
R15: res; {Ri}
R16: res; 1k
U1: UniversalOpamp2
V1: voltage; PULSE(-1 1 0 1m 0 0 1m); AC 1
V2: voltage; 9V
V3: voltage; -9V
Named nets: 0, VCC, OUT, IN, V1, V2, V3, V4, V5, VB9, VB10, VEE, V6, V7, V8, V9, V10, V11
;ac oct 100 10 100k
.tran 0 100m 97m
.param Ri 10k
.param Rq 100
