ryood/TLF01/TLF01_Antilog/Antilog_NPNO/spice/Antilog_NPNO - R9.asc

C1: cap; 100p
Q1: npn
Q2: npn
R1: res; 100k
R2: res; 47k
R3: res; 47k
R4: res; 10k
R5: res; 2.5k
R6: res; 20k
R7: res; 1k
R8: res; 1k
R9: res; {Rc}
R10: res; 1k
RL: res; 10k
U1: UniversalOpamp2
U2: UniversalOpamp2
V1: voltage; {VCutoff}
V2: voltage; PULSE(0 2 0 1m 1n 1n 1m)
V3: voltage; 0
V4: voltage; 9
V5: voltage; -9
Named nets: VEE, VCC, 0, CUTOFF, LFO, EG
;.step param Vcutoff list -5 0 5
.tran 3m
.param Vcutoff 5
.step param Rc list 47k 68k 82k 100k
