ryood/TLF01/TLF01_Antilog/Antilog-MM/spice/AntilogMM.asc

C8: cap; 100p
Q11: pnp; QA1015
Q12: npn; QC1815
R1: res; 680
R2: res; {RL}
R3: res; {10k-Rref}
R4: res; {Rref}
R17: res; 2.2k
R18: res; 68k
R20: res; 330
R21: res; 47k
V2: voltage; 9V
V3: voltage; -9V
V4: voltage; SINE(0.5 0.5 1k)
V6: voltage; 5V
Named nets: 0, VCC, VEE, In, VREF, OUT
;ac oct 100 10 100k
.tran 0 10m 7m
.param Rref 5k
.step param RL list 4.7k 10k 22k
