ryood/TLF01/TLF01_Antilog/Antilog-MM/spice/TLF01+AntilogMM.asc

C1: cap; 10uF
C2: cap; {Cfc}
C3: cap; {Cfc}
C4: cap; {Cfc}
C5: cap; {Cfc}
C6: cap; 220uF
C7: cap; 10uF
C8: cap; 100p
Q1: npn; QC1815
Q2: npn; QC1815
Q3: npn; QC1815
Q4: npn; QC1815
Q5: npn; QC1815
Q6: npn; QC1815
Q7: npn; QC1815
Q8: npn; QC1815
Q9: npn; QC1815
Q10: npn; QC1815
Q11: pnp; QA1015
Q12: npn; QC1815
R1: res; 330
R2: res; {Rv}
R3: res; 150
R4: res; 150
R5: res; 150
R6: res; 150
R7: res; {Rv2}
R8: res; 1k
R9: res; 1k
R10: res; 1.5k
R11: res; 1.5k
R12: res; 100k
R13: res; 100k
R14: res; {Rq}
R15: res; 47k
R16: res; 680
R17: res; 2.2k
R18: res; 68k
R20: res; 330
R21: res; 47k
U1: UniversalOpamp2
V1: voltage; PULSE(-0.5 0.5 0 1m 0 0 1m); AC 1
V2: voltage; 9V
V3: voltage; -9V
V4: voltage; PULSE(-0.5 0.5 0 10m 0 0 10m)
V5: voltage; SINE(0 0.5 50)
V6: voltage; 5V
Named nets: 0, VCC, OUT, AudioIn, V1, V2, V3, V4, V5, VB9, VB10, VEE, VREF, Envelope, LFO
;ac oct 100 10 100k
.tran 0 100m 60m
.param Rq 1k
.param Cfc 68nF
.param Rv 390
.param Rv2 200
Antilog
