ryood/TLF01/(list of files, drawings)

Other design files:
fritzing/MoogLadder_CS_JFET_V2.fzz
fritzing/TLF01結線図.fzz
TLF01_Antilog/Antilog-MM/fritzing/AntiLog-MM_Unit_Test.fzz
TLF01_Antilog/Antilog-MM/fritzing/TLF01+Antilog-MM_Test.fzz
TLF01_Antilog/Antilog-MM/fritzing/TLF01+Antilog_ Analog2.0.fzz
TLF01_Antilog/Antilog-MM/fritzing/TLF01+Antilog_ MiniMoog.fzz
TLF01_Antilog/Antilog_NPNO/fritzing/Antilog_Diff_Unit_Test2.fzz
TLF01_Antilog/Antilog_NPNO/fritzing/Antilog_Diff_Unit_Test.fzz
TLF01_Antilog/Antilog_NPNO/fritzing/Antilog_NPNO.fzz
TLF01_Antilog/Antilog_NPNO/fritzing/TLF01+Antilog_ Analog2.0.fzz
