ryood/TLF01/TLF01_Antilog/Antilog_NPNO/eagle/Antilog-NPNO/Antilog-NPNO.brd

## EAGLE design TLF01_Antilog/Antilog_NPNO/eagle/Antilog-NPNO/Antilog-NPNO.brd (2019-04-27)

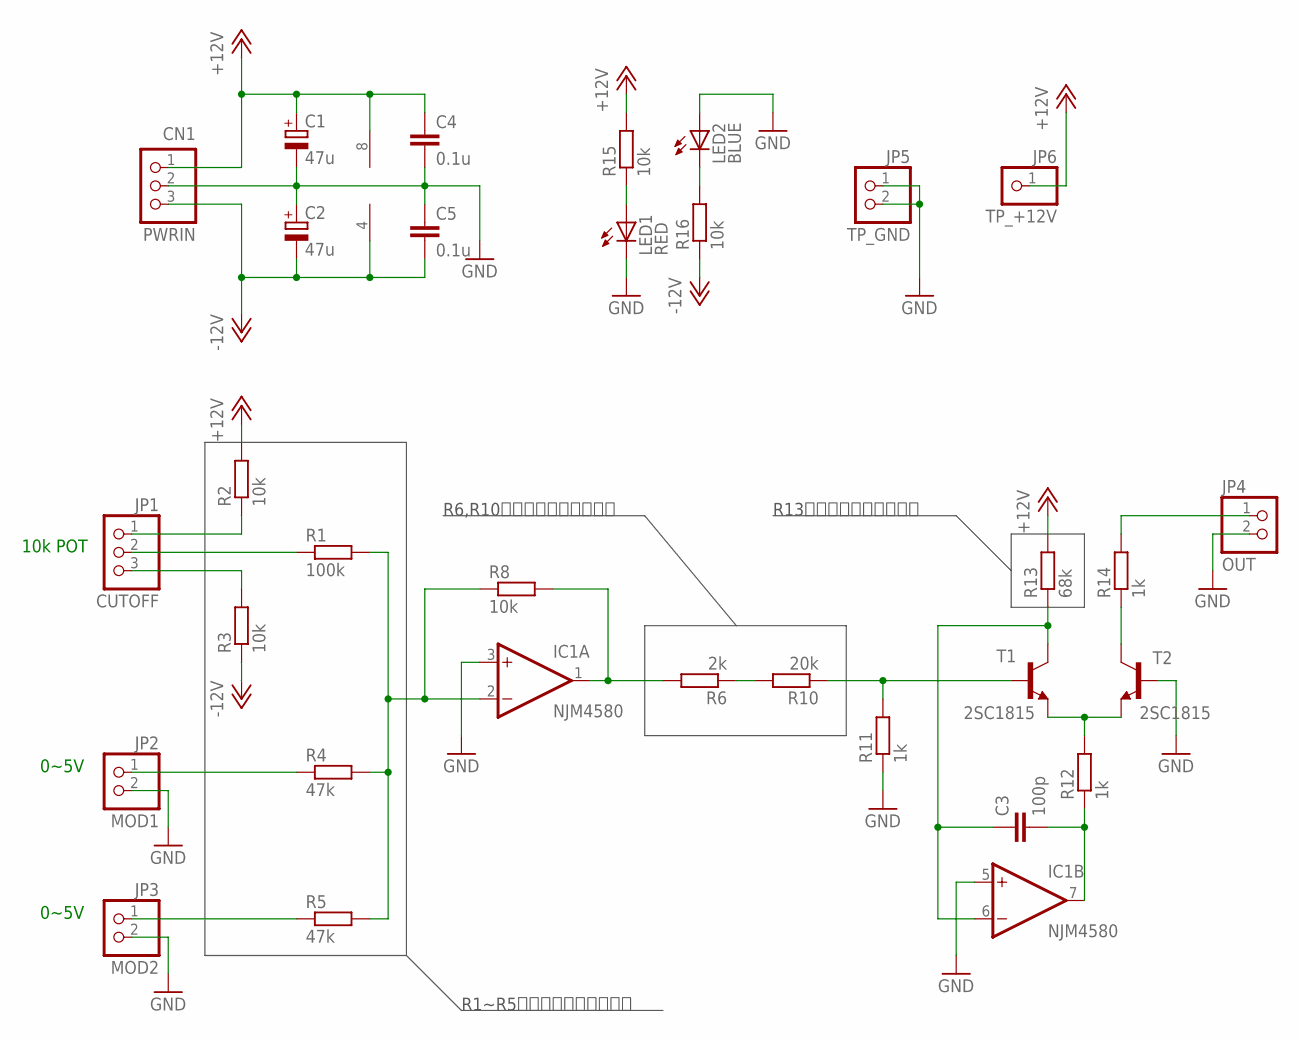
[picture p44: schematic Antilog-NPNO.sch]

Parts:
C1, C2: 47u; E2,5-6
C3: 100p; C050-024X044
C4, C5: 0.1u; C025-024X044
CN1: PWRIN; B3B-XH-A
IC1: NJM4580; DIL08
JP1: CUTOFF; 1X03
JP2: MOD1; 1X02
JP3: MOD2; 1X02
JP4: OUT; 1X02
JP5: TP_GND; 1X02
JP6: TP_+12V; 1X01
LED1: RED; LED3MM
LED2: BLUE; LED3MM
R1: 100k; 0207/7
R2, R3, R8, R15, R16: 10k; 0207/7
R4, R5: 47k; 0207/7
R6: 2k; 0207/7
R10: 20k; 0207/7
R11, R12, R14: 1k; 0207/7
R13: 68k; 0207/7
T1, T2: 2SC1815; TO92-ECB

Connections:
+12V: C1.+, C4.1, CN1.1, IC1.8 (V+), JP6.1, R2.2, R13.2, R15.2
-12V: C2.-, C5.2, CN1.3, IC1.4 (V-), R3.1, R16.1
GND: C1.-, C2.+, C4.2, C5.1, CN1.2, IC1.3 (+IN), IC1.5 (+IN), JP2.2, JP3.2, JP4.2, JP5.1, JP5.2, LED1.K (C), LED2.A, R11.1, T2.B
unnamed: JP3.1, R5.1
unnamed: R10.1, R11.2, T1.B
unnamed: JP1.2, R1.1
unnamed: JP2.1, R4.1
unnamed: IC1.1 (OUT), R6.2, R8.2
unnamed: R6.1, R10.2
unnamed: JP1.1, R2.1
unnamed: JP1.3, R3.2
unnamed: IC1.2 (-IN), R1.2, R4.2, R5.2, R8.1
unnamed: R14.1, T2.C
unnamed: LED1.A, R15.1
unnamed: JP4.1, R14.2
unnamed: R12.2, T1.E, T2.E
unnamed: C3.2, IC1.7 (OUT), R12.1
unnamed: C3.1, IC1.6 (-IN), R13.1, T1.C
unnamed: LED2.K (C), R16.2

Notes on the sheet:
10k POT
0~5V
R1~R5はピンソケットで実装
R6,R10はピンソケットで実装
R13はピンソケットで実装

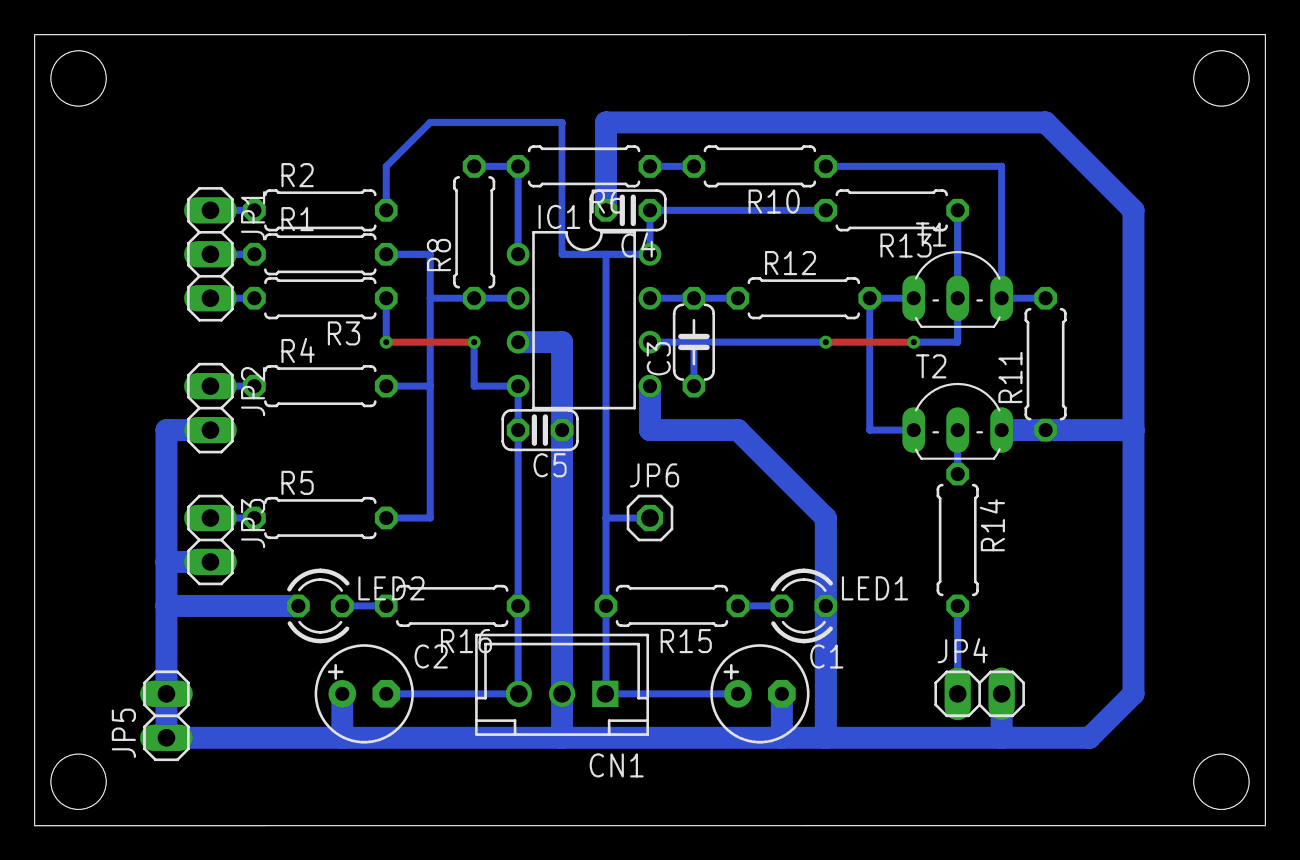
[picture p45: board Antilog-NPNO.brd from above]

Board: 2 copper layers, 71.1 x 45.7 mm, 31 parts (0 on the bottom side), 19 nets.
