ryood/TLF01/TLF01_Antilog/Antilog-MM/eagle/TLF01_Antilog_MM/AntilogMM.brd

## EAGLE design TLF01_Antilog/Antilog-MM/eagle/TLF01_Antilog_MM/AntilogMM.brd (2018-08-28)

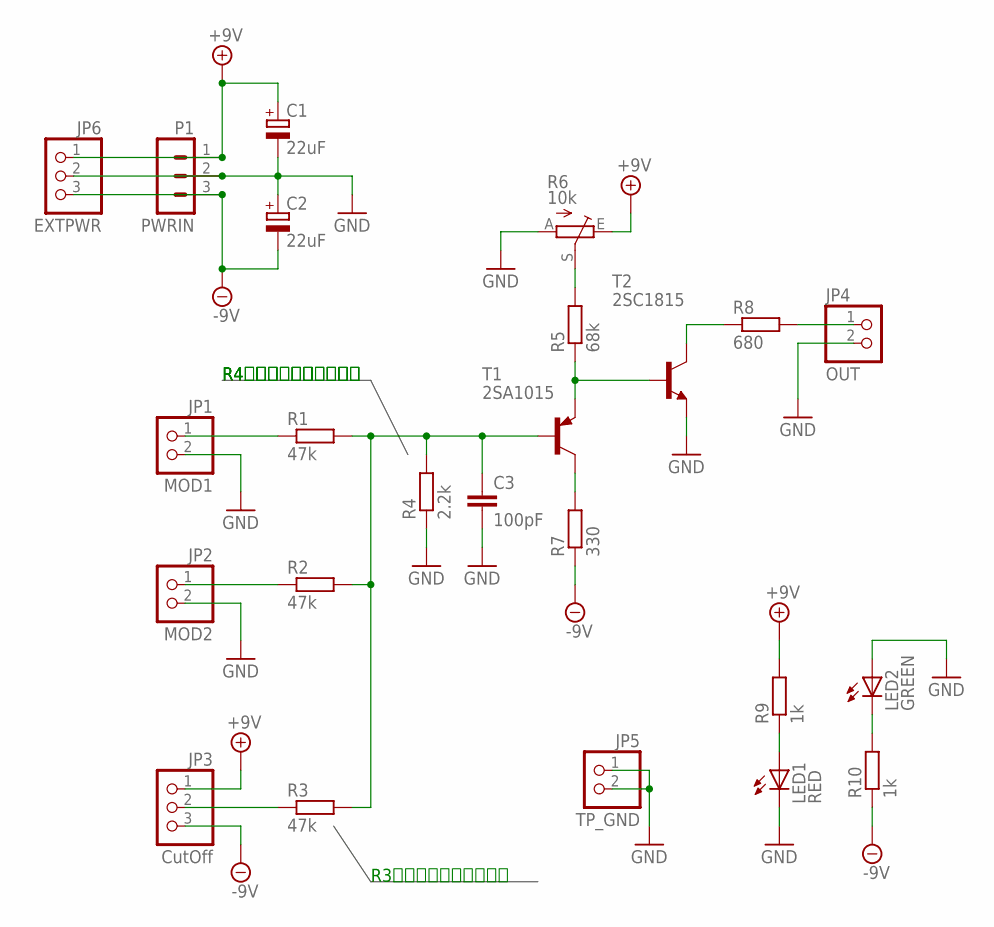
[picture p46: schematic AntilogMM.sch]

Parts:
C1, C2: 22uF; E2,5-6
C3: 100pF; C050-024X044
JP1: MOD1; 1X02
JP2: MOD2; 1X02
JP3: CutOff; 1X03
JP4: OUT; 1X02
JP5: TP_GND; 1X02
JP6: EXTPWR; 1X03
LED1: RED; LED3MM
LED2: GREEN; LED3MM
P1: PWRIN; B3B-EH-A
R1, R2, R3: 47k; 0207/7
R4: 2.2k; 0207/7
R5: 68k; 0207/7
R6: 10k; B25P
R7: 330; 0207/7
R8: 680; 0207/7
R9, R10: 1k; 0207/7
T1: 2SA1015; TO92-ECB
T2: 2SC1815; TO92-ECB

Connections:
+9V: C1.+, JP3.1, JP6.1, P1.1, R6.E, R9.2
-9V: C2.-, JP3.3, JP6.3, P1.3, R7.1, R10.1
GND: C1.-, C2.+, C3.2, JP1.2, JP2.2, JP4.2, JP5.1, JP5.2, JP6.2, LED1.K (C), LED2.A, P1.2, R4.1, R6.A, T2.E
unnamed: R8.1, T2.C
unnamed: R7.2, T1.C
unnamed: LED2.K (C), R10.2
unnamed: JP4.1, R8.2
unnamed: LED1.A, R9.1
unnamed: R5.2, R6.S
unnamed: R5.1, T1.E, T2.B
unnamed: C3.1, R1.2, R2.2, R3.2, R4.2, T1.B
unnamed: JP1.1, R1.1
unnamed: JP2.1, R2.1
unnamed: JP3.2, R3.1

Notes on the sheet:
R4はピンソケットで実装
R3はピンソケットで実装

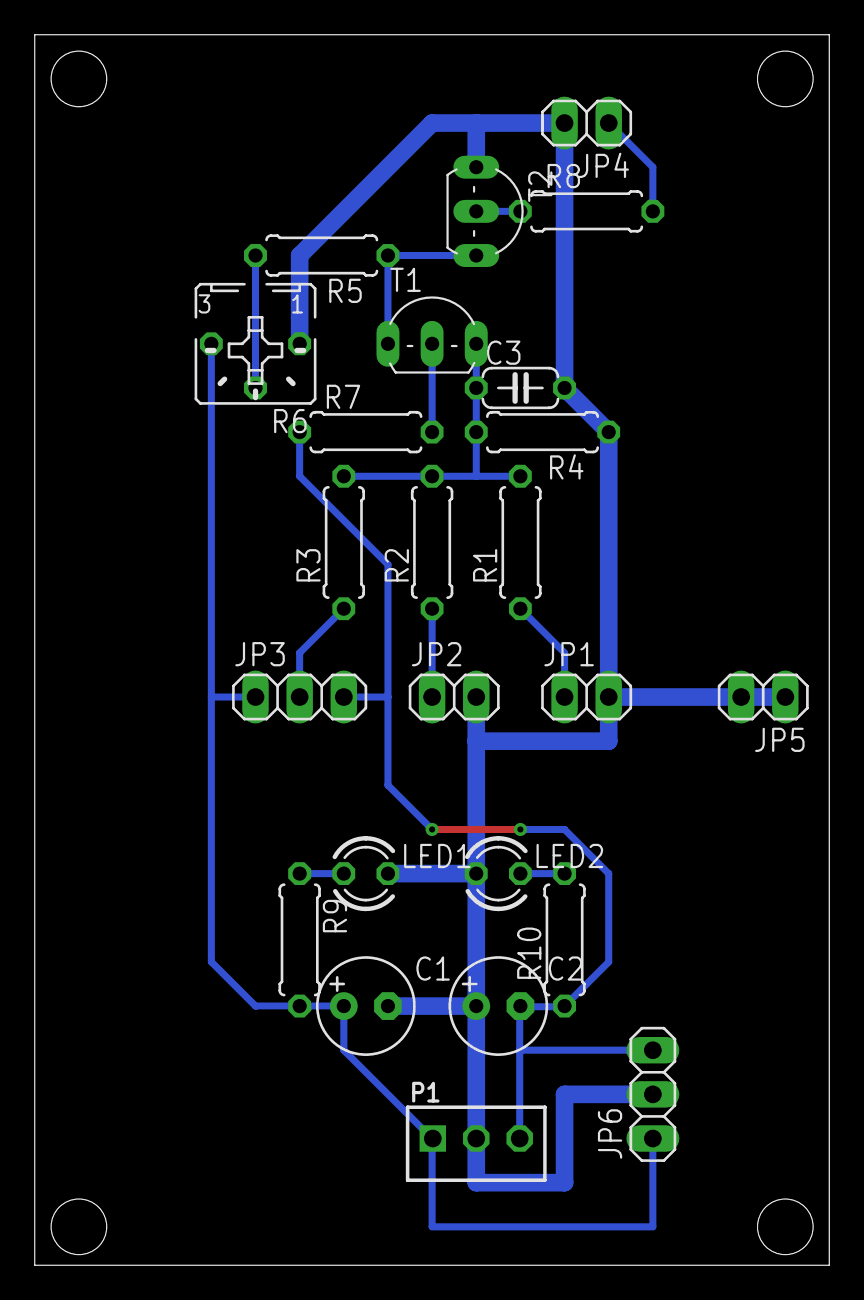
[picture p47: board AntilogMM.brd from above]

Board: 2 copper layers, 45.7 x 70.8 mm, 24 parts (0 on the bottom side), 14 nets.
