ryood/TLF01/(commit log)

2018-06-17 Update: eagle files
    [TLF01.brd, TLF01.sch]
2018-06-18 Update eagle files
    [TLF01.brd, TLF01.sch]
2018-06-23 TLF01テスト表
    [TLF01テスト表.xlsx]
2018-06-23 Update eagle board design
    [TLF01.brd]
2018-07-07 AntiLog-MM基板設計
    [AntiLog-MMテスト表.xlsx, AntilogMM.brd, AntilogMM.sch, TLF01 + AntiLog ブロック図.xlsx, TLF01+Antilog_ Analog2.0.fzz, TLF01+Antilog_ MiniMoog.fzz]
2018-08-28 Update: AntilogMM
    [AntiLog-MM_Unit_Test.fzz, AntiLog-MMテスト表.xlsx, AntilogMM.brd, AntilogMM.sch, TLF01+Antilog-MM_Test.fzz]
2019-04-16 Add: Antilog_NPNO
    [AntiLog-MM_Unit_Test.fzz, AntiLog-MMテスト表.xlsx, Antilog-NPNO.sch, AntilogMM.brd, AntilogMM.sch, Antilog_Diff_Unit_Test.fzz, Antilog_Diff_Unit_Test2.fzz, Antilog_NPNO.fzz]
2019-04-17 Add: Antilog_NPNO board design
    [Antilog-NPNO.brd, Antilog-NPNO.sch, Antilog_NPNO.fzz]
2019-04-17 Update: Antilog-NPNO board Design
    [Antilog-NPNO.brd]
2019-04-27 Add:テスト表
    [Antilog-NPNO.brd, Antilog-NPNO.sch, Antilog-NPNOテスト表.xlsx]
2019-05-03 Add: eagle files (TLF01_toz)
    [TLF01.brd, TLF01.sch]
2019-05-04 Update: TLF01_toz
    [TLF01.brd]
2019-06-01 TLF01故障検査
2019-06-16 Add:TLF01_tozテスト表_20190612.xlsx
    [TLF01_tozテスト表_20190612.xlsx]
2020-10-12 Ad:d Analog Discovery 2
    [Antilog-NPNO_Test_Diagram.xlsx, Antilog_NPNO_InOut.xlsx]
