ryood/TLF01/(notices)

Notices in the files:
parts and their libraries:
con-jst-eh: Copyright (C) 2016, Bob Starr
